zyyyyy07/hpipac-heater/3-mechanical/README.md

[← 上一步:采购](../2-purchase/README.md) · [总览](../README.md) · [下一步:接线 →](../4-electronics/README.md)

# 第 3 步 · 加工金属件、打印外壳

这一步把 8 种定制零件做出来:四件金属件找 CNC 加工厂,四种塑料件 3D 打印(注射筒加热套半壳要做 2 件)。

**下单前先量两个尺寸,在三维查看器里改成实测值再导出**:注射筒外径、加湿罐底面直径。默认值是我估的。

| 图号 | 零件 | 文件 | 做法 | 说明 |
| --- | --- | --- | --- | --- |
| HP-01 | 喷嘴头 | [models/cnc/](models/cnc/)`01_nozzle_tip_316L.step` | 精密车削,316L | 外径 10、高 14 的小件。喷口直径 2.0,与外圆同轴度 0.03 |
| HP-02 | 定心旋流片 | [models/cnc/](models/cnc/)`02_nozzle_spider_316L.step` | 线切割或微铣,316L | 直径约 6、厚 4。中心孔穿毛细管,三条切向槽 |
| HP-03 | 喷头歧管 | [models/cnc/](models/cnc/)`03_nozzle_manifold_AL6061.step` | CNC,6061 铝 | 36×30×50 的块。只接触气体 |
| HP-04 | 注射筒加热套 半壳 | [models/print/](models/print/)`04_syringe_jacket_half.stl` | 3D 打印,**做 2 件** | 两片对扣包住针筒 |
| HP-05 | 加湿铝盘 | [models/cnc/](models/cnc/)`05_humidifier_plate_AL6061.step` | CNC,6061 铝 | 上面放加湿罐,下面贴加热片 |
| HP-06 | 加湿底座 | [models/print/](models/print/)`06_humidifier_base.stl` | 3D 打印,PETG 或耐温 ABS | 托住铝盘,里面走线 |
| HP-07 | 主控盒 | [models/print/](models/print/)`07_control_box_body.stl` | 3D 打印 | 侧面 7 个航空插座孔 |
| HP-08 | 主控盒盖 | [models/print/](models/print/)`08_control_box_lid.stl` | 3D 打印 | 7 英寸触摸屏窗、3 个指示灯、中止键、消音键、蜂鸣器 |

## 发给加工厂

- 图纸是 [drawings/HP-drawings.pdf](drawings/HP-drawings.pdf),每个零件一张 A3,含三视图、孔表、公差和技术要求。二维线稿在 [drawings/dxf/](drawings/dxf/)。
- 金属件发图纸第 1、2、3、5 页,加 `models/cnc/` 里的四个 STEP。
- 打印件发 `models/print/` 里的 STL 或 STEP。
- **喷嘴头和旋流片是毫米级的精密件,普通 CNC 厂不一定做得了。** 找做精密车削、线切割或医疗器械零件的厂。第一轮试水可以先用光固化树脂(SLA)打印这两件,便宜、快,能验证雾化原理,但尺寸精度和表面比金属差。
- 图纸由脚本生成,没有经过加工厂审图,下单前请对方确认能否按图加工。

## 看模型和改尺寸

```
pip install cadquery reportlab ezdxf
cd 3-mechanical/tools
python studio.py        (浏览器打开 http://127.0.0.1:8095)
```

可以旋转、剖切、拖滑块改尺寸。左边列表下方有装配视图:气助雾化喷头(点“剖切”看内部)、注射筒加热套、加湿加热底座、手术室整体布置。点“保存并导出”后模型和图纸按新尺寸重新生成。

喷口直径和毛细管外径决定环形气隙的面积,进而决定气流速度和雾滴大小。这两个参数是第一个要通过试验调的。

## 喷头怎么装

1. 旋流片压进喷嘴头内腔,距喷口端面 5 mm,三条槽朝向一致。
2. 喷嘴头的细段插进喷头杆下端,激光焊或医用环氧胶封固,外表面齐平无台阶。
3. 喷头杆上端插进歧管底孔 20 mm,O 形圈加环氧胶密封。
4. 毛细管从歧管顶部穿入,穿过旋流片中心孔,末端伸出喷口 0.5 mm,顶部用 M6 压紧接头锁住并密封。伸出量可以松开接头微调。
5. 歧管侧面装进气接头和测压接头;背面贴加热片;两只测温探头涂导热硅脂插进测温孔;外面包保温棉。
6. 通气检查:堵住喷口,歧管充气到 100 kPa,泡水里看有无气泡。

毛细管要在喷口正中。装好后对着光从喷口正面看,环形缝隙应当一圈均匀。偏了雾会歪向一边。

## 其他装配要点

- **注射筒加热套**:硅胶加热片贴在一片半壳内侧,外面垫保温棉;两只测温探头贴在加热片和针筒之间。不要挡住注射泵的推杆和针筒刻度。
- **加湿加热底座**:加热片贴在铝盘底面,铝盘用 3 颗 M3 沉头螺丝固定在底座上,中间垫硅胶隔热垫。铝盘最高到 85 ℃,底座外壁会热。
- **喷头的固定**:喷头连歧管约 150 g,加上输气管的拉力,不能只靠穿刺器撑着。输气管和药液细管要用支架或绑带托住,不让重量和拉力落在喷头上。
- **主控盒**:模块的固定位置按实物在盒底打孔或贴双面胶。

以上装配方式都没有做过实物验证。

---

[← 上一步:采购](../2-purchase/README.md) · [总览](../README.md) · [下一步:接线 →](../4-electronics/README.md)
