zyyyyy07/hpipac-heater/1-design/interface-spec.md

[← 设计方案](README.md) · [总览](../README.md)

# 接口约定(固件、服务器、页面共用)

这份文件是固件、盒内服务程序和触摸屏界面之间的约定。改了一处,另外两处要同时改。

## 1. 系统组成

hPIPAC 前端加热系统由一台主机、四路加热和一只气助加热雾化喷头组成。循环泵送出的温热加湿 CO₂ 从喷头喷出,同时当作雾化气把药液打成雾。主机不控制推药的注射泵和气腹机,这两台是独立的成品设备。

| 代号 | 名称 | 加热什么 | 控制目标 | 硬上限 |
| --- | --- | --- | --- | --- |
| SYR | 注射筒加热套 | 注射泵针筒里的药液 | 套温 = 目标温度 | 套温 43.0 ℃ |
| NOZ | 喷头歧管加热 | 喷头体外部分的歧管(气和药液在这里汇合进喷头杆) | 歧管温度 = 目标温度 | 歧管 43.0 ℃ |
| HUM | 加湿加热底座 | 加湿罐里的水,使 CO₂ 加热加湿 | 罐出口气温 = 目标温度 + 1 ℃ | 底座 85 ℃,出口气温 45 ℃ |
| TUBE | 加热输气管 | 加湿罐到喷头歧管的输气管 | 喷头端气温 = 目标温度 | 喷头端气温 43.5 ℃ |

另有一台循环泵 PUMP,把腹腔里的 CO₂ 经过滤器抽出、加热加湿后从喷头送回,流量 0–15 L/min。喷雾时这股气流就是雾化气,所以喷雾阶段泵必须转。

目标温度 `target`:37.0–43.0 ℃,默认 42.0 ℃。药液通路上任何加热面的设定值都不超过 43.0 ℃。

## 2. 传感器

| 字段 | 含义 | 单位 |
| --- | --- | --- |
| `syr1`, `syr2` | 注射筒加热套温度(控制、保护各一只) | ℃ |
| `noz1`, `noz2` | 喷头歧管温度(控制、保护各一只) | ℃ |
| `humPlate` | 加湿底座温度 | ℃ |
| `humOut` | 加湿罐出口气温 | ℃ |
| `gasEnd` | 输气管喷头端气温 | ℃ |
| `ip1`, `ip2` | 腹腔内温度探头 1、2 | ℃ |
| `press` | 腹腔压力(循环回路上测) | mmHg |
| `nozP` | 喷头歧管处的雾化气压(表压) | kPa |
| `flow` | 循环流量 | L/min |

传感器开路或短路时固件上报 `null`。

## 3. 阶段

```
IDLE → PREHEAT → READY → NEBULIZE → EXPOSE → EVAC → DONE → IDLE
```

| 阶段 | 含义 | 加热 | 循环泵 |
| --- | --- | --- | --- |
| IDLE | 待机 | 全关 | 关 |
| PREHEAT | 预热:药液、喷头歧管、加湿器升温;气腹建立后循环 CO₂ 给腹腔升温 | 四路全开 | `press` ≥ 8 mmHg(气腹已建立)后按设定流量,之前不转 |
| READY | 就绪:四路都到温,腹腔温度到目标 − 1 ℃ 以内(或操作者手动确认) | 保持 | 按设定流量 |
| NEBULIZE | 喷雾:操作者启动注射泵推药 | 四路保持 | 按 `nebFlow` 运转(这是雾化气,泵停了就不成雾) |
| EXPOSE | 暴露计时(默认 30 分钟) | SYR 关;NOZ 关;HUM、TUBE 保持 | 由 `circInExpose` 决定,默认关 |
| EVAC | 排气:提示操作者经密闭排气系统排空气腹 | 全关 | 关 |
| DONE | 结束,等待确认 | 全关 | 关 |

转换:
- `preheat` 命令:IDLE → PREHEAT。
- PREHEAT → READY:自动。条件是 SYR、NOZ 的两只传感器都在目标 ±0.5 ℃ 内,`gasEnd` ≥ 目标 − 1 ℃,并且 `ip1`、`ip2` 的平均值 ≥ 目标 − 1 ℃。腹腔条件可用 `ready` 命令手动跳过。
- READY 掉回 PREHEAT:任一条件失去超过 60 秒。
- `nebulize` 命令:READY → NEBULIZE。只允许从 READY 进入。
- `expose` 命令:NEBULIZE → EXPOSE,开始计时。
- EXPOSE → EVAC:计时到 `exposeMin` 自动转,或 `evac` 命令提前转。
- `finish` 命令要发两次:第一次 EVAC → DONE,第二次 DONE → IDLE。
- **喷雾阶段泵一停就不成雾了,而注射泵不归本机控制,还在推药。** 这时任何让泵停下的报警(压力高、压力低、喷头堵塞、传感器故障、腹腔过温、气体过温)都要求操作者立即停注射泵。触摸屏在这种情况下必须用最醒目的方式提示“立即停止注射泵”,红灯快闪,蜂鸣器急响。
- 循环泵不转的时候(气腹未建立、暴露默认、报警停泵后),HUM 的底座温度上限从 85 ℃ 降到 60 ℃ 待机,避免没有气流时把底座烧到很高。
- `abort` 命令:任何阶段 → EVAC(加热和泵立即全关)。

## 4. 报警

高级报警立即把相关加热和循环泵关掉。带“锁定”的只有重新上电才能清除。

| 名称 | 条件 | 级别 | 动作 |
| --- | --- | --- | --- |
| `OVERTEMP_DRUG` | `syr1/2` 或 `noz1/2` ≥ 43.8 ℃ | 高,锁定 | SYR、NOZ 关 |
| `OVERTEMP_GAS` | `gasEnd` ≥ 44.5 ℃,或 `humOut` ≥ 46 ℃,或 `humPlate` ≥ 88 ℃ | 高,锁定 | HUM、TUBE、PUMP 关 |
| `IP_HIGH` | `ip1` 或 `ip2` ≥ 43.5 ℃ | 高 | 四路全关,PUMP 关;降到 42.5 ℃ 以下并经 `ack` 才恢复 |
| `SENSOR` | 成对传感器相差 > 1.5 ℃ 持续 10 秒,或任一控制用传感器为 `null` | 高,锁定 | 对应通路关 |
| `PRESS_HIGH` | `press` ≥ 18 mmHg 持续 3 秒 | 高 | PUMP 关 |
| `PRESS_LOW` | 循环泵运转中 `press` ≤ 6 mmHg 持续 5 秒。泵没转时不判 | 高 | PUMP 关(可能漏气),`ack` 后恢复 |
| `WATER_LOW` | 循环泵已连续运转 ≥ 120 秒,`humPlate` ≥ 75 ℃ 而 `humOut` 低于目标 3 ℃ 以上,持续 120 秒。泵没转时不判 | 中 | HUM 关,`ack` 后恢复 |
| `NOZ_BLOCK` | `nozP` ≥ 150 kPa 持续 3 秒(喷嘴堵了或输气管打折) | 高 | PUMP 关,`ack` 后恢复 |
| `NOZ_LOW` | NEBULIZE 中循环泵已运转 ≥ 10 秒,`nozP` < 30 kPa 持续 10 秒(气压不够,雾滴会变粗;可能漏气或流量太低) | 中 | 仅提示 |
| `PREHEAT_SLOW` | PREHEAT 超过 60 分钟 | 中 | 仅提示 |
| `IP_LOW` | EXPOSE 中 `ip` 平均值低于目标 2 ℃ 以上,持续 5 分钟 | 中 | 仅提示 |
| `EXPOSE_END` | 暴露计时到 | 中 | 仅提示 |

## 5. 遥测(固件 → 服务器)

固件每 2 秒 `POST /api/device/telemetry`,JSON:

```json
{"id":"HP-001","ph":"PREHEAT","target":42.0,"exposeMin":30,"flowSet":10.0,"nebFlow":12.0,"circInExpose":false,
 "t":{"syr1":41.8,"syr2":41.7,"noz1":42.0,"noz2":41.9,"humPlate":61.2,"humOut":43.0,"gasEnd":41.6,"ip1":40.2,"ip2":39.8},
 "press":12.1,"nozP":62.0,"flow":9.8,
 "duty":{"syr":35,"noz":20,"hum":60,"tube":40,"pump":65},
 "phSec":412,"exposeLeft":-1,"al":["IP_LOW"],"muted":false}
```

- `ph`:阶段名。`phSec`:进入当前阶段的秒数。`exposeLeft`:暴露剩余秒数,不在 EXPOSE 时为 −1。
- `duty`:各路输出占空比,0–100。
- 服务器的响应体:`{"cmds":[...]}`,每条命令形如 `{"kind":"preheat"}` 或 `{"kind":"target","value":41.5}`。

## 6. 命令

| `kind` | `value` | 说明 |
| --- | --- | --- |
| `preheat` | — | 开始预热 |
| `ready` | — | 手动确认就绪(跳过腹腔温度条件) |
| `nebulize` | — | 标记喷雾开始 |
| `expose` | — | 标记喷雾结束,开始暴露计时 |
| `evac` | — | 提前结束暴露 |
| `finish` | — | 结束本次手术 |
| `abort` | — | 中止:加热和泵全关,进入 EVAC |
| `target` | 37.0–43.0 | 改目标温度 |
| `flow` | 0–15 | 改循环流量 L/min(预热、就绪、暴露阶段用) |
| `nebFlow` | 5–15 | 改喷雾阶段的雾化气流量 L/min,默认 12 |
| `exposeMin` | 1–60 | 改暴露时间 |
| `circInExpose` | true/false | 暴露阶段是否循环 |
| `ack` | — | 确认可恢复的报警 |
| `mute` | — | 消音 2 分钟 |

固件拒绝超范围的值和当前阶段不允许的命令。

## 7. 盒内服务程序接口

主机是一个整体,只在现场操作,**没有遥控**。主控盒里的树莓派运行服务程序,开一个只供盒内使用的 Wi-Fi 热点,ESP32 连这个热点,不接医院网络。触摸屏全屏显示服务程序提供的本机界面。

| 方法 | 路径 | 说明 |
| --- | --- | --- |
| POST | `/api/device/telemetry` | ESP32 上报,返回待执行命令 |
| GET | `/api/state` | 返回 `{now, devices:[{id, online, last, case}]}` |
| POST | `/api/cmd` | `{dev, kind, value}`,触摸屏上的操作排入命令队列 |
| GET | `/api/history?dev=&sec=` | 最近若干秒的遥测点,供触摸屏画曲线 |
| GET | `/api/case/log?dev=&case=` | 一次手术的全部记录(CSV) |
| GET | `/`、`/local` | 触摸屏本机界面(800×480) |
| GET | `/panel` | 主机面板模拟页面,开发和演示用 |

记录:每次从 PREHEAT 开始到回到 IDLE,服务程序自动把每条遥测写进一个 CSV 文件,存在树莓派的存储卡上,手术结束后可以拷出来。

设备 5 秒没有上报视为离线,触摸屏显示“主控无响应”。
