zyyyyy07/hpipac-heater/2-purchase/README.md

[← 上一步:方案设计](../1-design/README.md) · [总览](../README.md) · [下一步:结构件 →](../3-mechanical/README.md)

# 第 2 步 · 采购

照下面的清单买齐零件。定制的金属件和打印件不在这里买,在[第 3 步](../3-mechanical/README.md)下单加工。价格是粗略估计,仅用于预算。

## 喷头用的外购件

| # | 零件 | 规格 | 数量 | 约价 元 |
| --- | --- | --- | --- | --- |
| 1 | 喷头杆 | 316L 不锈钢管,外径 10 mm、壁厚 1 mm,切 200 mm,两端去毛刺 | 2 | 30 |
| 2 | 药液毛细管 | 316L 不锈钢毛细管,外径 1.6 mm、内径 1.0 mm,长 300 mm,端面平整无毛刺 | 5 | 30 |
| 3 | 毛细管接头 | M6 压紧接头(卡套或 PEEK 压环,适配 1.6 mm 管);1.6 mm 管转鲁尔接头 | 各 2 | 60 |
| 4 | 进气接头 | G1/8 宝塔或快插接头,适配输气管;M5 测压接头 | 各 2 | 20 |
| 5 | 密封 | O 形圈(内径 10 mm);医用环氧胶 | 1 套 | 30 |
| 6 | 药液细管 | 鲁尔接口延长管,内径约 1 mm,长 1.5 m | 若干 | 5/根 |

## 主机和控制

| # | 零件 | 规格 | 数量 | 约价 元 |
| --- | --- | --- | --- | --- |
| 7 | 主控板 | ESP32-DevKitC(ESP32-WROOM-32,38 脚) | 1 | 25 |
| 8 | 模数转换 | ADS1115 16 位 I2C 模块 | 3 | 45 |
| 9 | 功率开关 | MOS 管驱动模块(3.3 V 逻辑可驱动,≥10 A) | 6 | 40 |
| 10 | 触摸屏 | 树莓派官方 7 英寸触摸屏(800×480) | 1 | 450 |
| 11 | 屏幕主机 | 树莓派 4B 或 3B+,16 GB 以上 TF 卡 | 1 | 350 |
| 12 | 声光 | 有源蜂鸣器模块;5 mm LED 红黄绿;330 Ω 电阻 | 1 套 | 8 |
| 13 | 按键 | 16 mm(中止)和 12 mm(消音)面板自复位按键 | 各 1 | 10 |
| 14 | 电源 | 24 V 10 A 开关电源(样机用普通电源,成品必须换医用电源);24 V 转 5 V 3 A 降压模块 2 个;15 A 保险丝座 | 1 套 | 150 |
| 15 | 连接器与线 | GX16 航空插头座 5 对,GX12 2 对,硅胶线 | 1 套 | 80 |

## 测温和测压

| # | 零件 | 规格 | 数量 | 约价 元 |
| --- | --- | --- | --- | --- |
| 16 | 温度探头 | 10 kΩ B3950 1% NTC,Ø2 mm 探头带线(注射筒套 2、歧管 2、加湿底座 1) | 6 | 20 |
| 17 | 气温探头 | 同上,细探头,插进输气管两端的测温口 | 2 | 8 |
| 18 | 腹腔温度探头 | 医用体腔温度探头(热敏电阻,线长 ≥2 m)。台架阶段可用防水 NTC 代替 | 2 | 100–400 |
| 19 | 精密电阻 | 10 kΩ 0.1%(腹腔探头阻值不同时按探头配);10 kΩ、20 kΩ 1% 分压用 | 1 套 | 10 |
| 20 | 腹腔压力传感器 | 0–50 mmHg(约 0–7 kPa)表压,0.5–4.5 V 输出 | 1 | 80–200 |
| 21 | 雾化气压传感器 | 0–200 kPa 表压,0.5–4.5 V 输出,M5 或鲁尔接口 | 1 | 50–150 |

## 加热

| # | 零件 | 规格 | 数量 | 约价 元 |
| --- | --- | --- | --- | --- |
| 22 | 注射筒加热片 | 硅胶加热片 24 V 20 W,约 80×90 mm,带背胶 | 1 | 30 |
| 23 | 歧管加热片 | 聚酰亚胺薄膜加热片 24 V 10 W,约 30×45 mm | 1 | 15 |
| 24 | 加湿底座加热片 | 圆形硅胶加热片 24 V 120 W,直径约 90 mm | 1 | 60 |
| 25 | 独立过温保护 | XH-W1209 数显温控模块(24 V 版或配降压) | 3 | 30 |
| 26 | 机械过温保护 | KSD9700 常闭温控开关:50 ℃ 2 只(药液侧),95 ℃ 1 只(加湿底座);温度保险丝 72 ℃ 2 只、115 ℃ 1 只 | 1 套 | 15 |
| 27 | 保温 | 3 mm 气凝胶毡或闭孔泡棉;3 mm 硅胶隔热垫 | 1 | 30 |

## 气路

进腹腔的气体经过的部分都用无菌一次性耗材。

| # | 零件 | 规格 | 数量 | 约价 元 |
| --- | --- | --- | --- | --- |
| 28 | 加湿罐 | 一次性呼吸湿化罐(自动加水式),底面是铝盘,无菌。要能承受约 100 kPa 的内压,买之前向厂家确认 | 若干 | 30–80/个 |
| 29 | 加热输气管 | 带加热丝的一次性输气管,长 1.5–2 m,耐压 ≥100 kPa | 若干 | 50–200/根 |
| 30 | 气溶胶过滤器 | 腹腔镜排烟用或呼吸回路用高效疏水过滤器(过滤效率 ≥99.99%),2 级串联 | 若干 | 20–60/个 |
| 31 | 循环泵 | 24 V 无油隔膜气泵或小型无油压缩机:12–15 L/min 时出口压力 ≥100 kPa,可调速,气路与电机隔离 | 1 | 300–800 |
| 32 | 管路和接头 | 耐压医用硅胶管或 PU 管、鲁尔接头、三通 | 1 套 | 80 |
| 33 | 灭菌注射用水 | 加湿罐用 | — | — |

普通呼吸湿化罐和输气管是按很低的压力设计的。本方案里它们在泵的出口侧,要承受几十 kPa。**买不到耐压的,就要把加湿罐放进一个耐压外罩里,或者改成泵在加湿罐之后。** 这一点我没有解决,见[第 7 步](../7-testing/README.md)的风险点。

## 安装和加工

| # | 零件 | 规格 | 数量 | 约价 元 |
| --- | --- | --- | --- | --- |
| 34 | 设备架 | 带托板的移动立杆或小推车;抱杆夹 | 1 | 200 |
| 35 | 固定 | 魔术贴绑带;M3、M4 螺丝 | 1 套 | 30 |
| 36 | 金属件加工 | 喷嘴头、定心旋流片(316L,精密小件),歧管、加湿铝盘(6061),见[第 3 步](../3-mechanical/README.md) | 1 套 | 800–2000 |
| 37 | 3D 打印 | 5 件,PETG | 1 套 | 150–300 |

## 由医院提供、不在本清单里的

注射泵和针筒、气腹机、穿刺器、密闭排气系统。本系统不改动它们。

**下单前先量两个尺寸**:注射筒外径、加湿罐底面直径。

台架测试还需要:经计量的温度计、细热电偶和记录仪、模型腹腔(密闭塑料箱加硅胶膜)、水柱压力计、电子天平(0.01 g)、食用色素或荧光素、生理盐水。测雾滴粒径需要激光粒度仪,通常要找有设备的实验室。

---

[← 上一步:方案设计](../1-design/README.md) · [总览](../README.md) · [下一步:结构件 →](../3-mechanical/README.md)
