zyyyyy07/hpipac-heater/3-mechanical/models/view/syr_assembly.stl

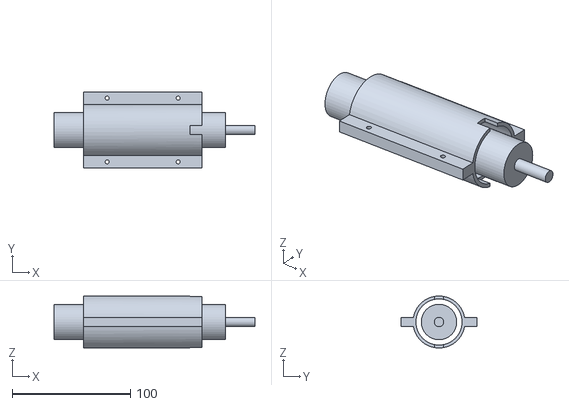
[picture p1: CAD file, 2026-11-13]
3-mechanical/models/view/syr_assembly.stl
170.0 x 64.0 x 43.9
