zyyyyy07/hpipac-heater/3-mechanical/models/view/hum_assembly.stl

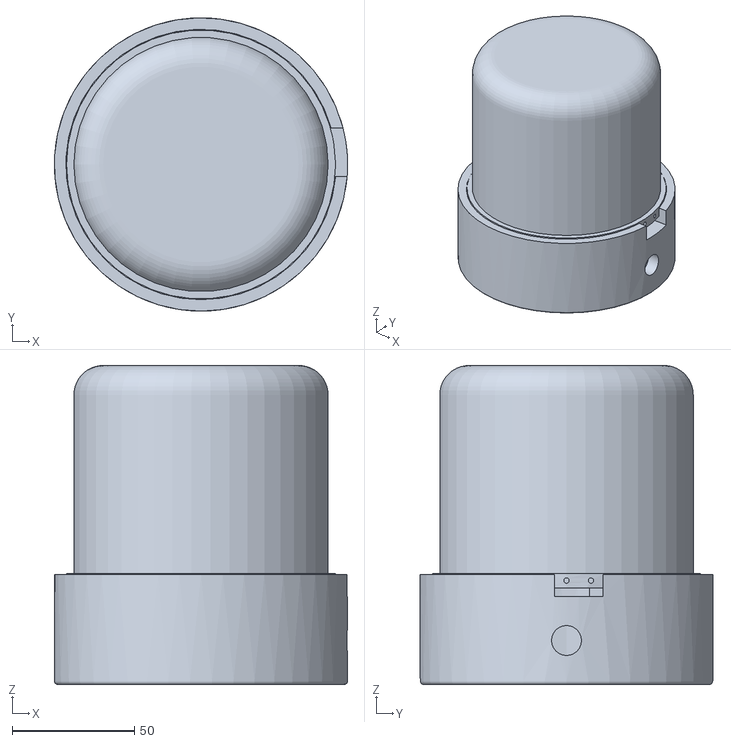
[picture p2: CAD file, 2026-11-13]
3-mechanical/models/view/hum_assembly.stl
120.0 x 120.0 x 130.5
