zyyyyy07/hpipac-heater/3-mechanical/models/view/room_assembly.stl

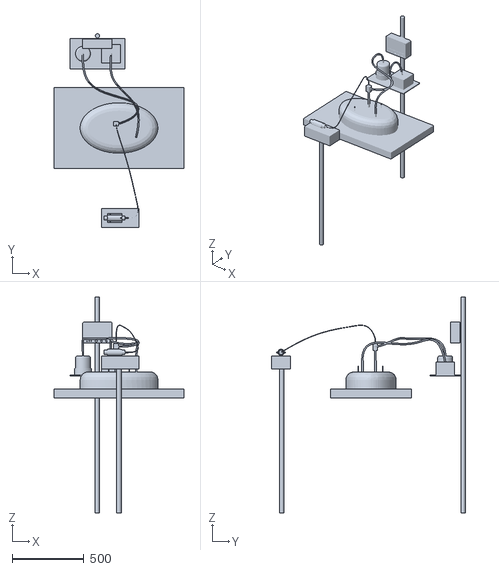
[picture p3: CAD file, 2026-11-13]
3-mechanical/models/view/room_assembly.stl
900.0 x 1345.0 x 1500.0
