zyyyyy07/hpipac-heater/3-mechanical/models/view/nozzle_assembly.stl

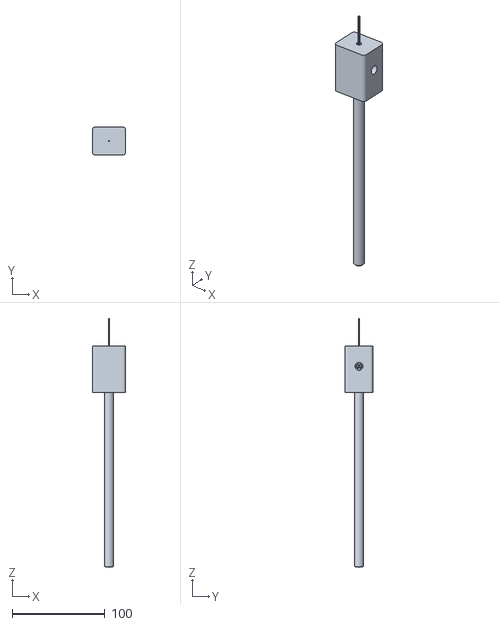
[picture p4: CAD file, 2026-11-13]
3-mechanical/models/view/nozzle_assembly.stl
36.0 x 30.0 x 268.0
