zyyyyy07/hpipac-heater/3-mechanical/drawings/dxf/01_nozzle_tip_316L.dxf

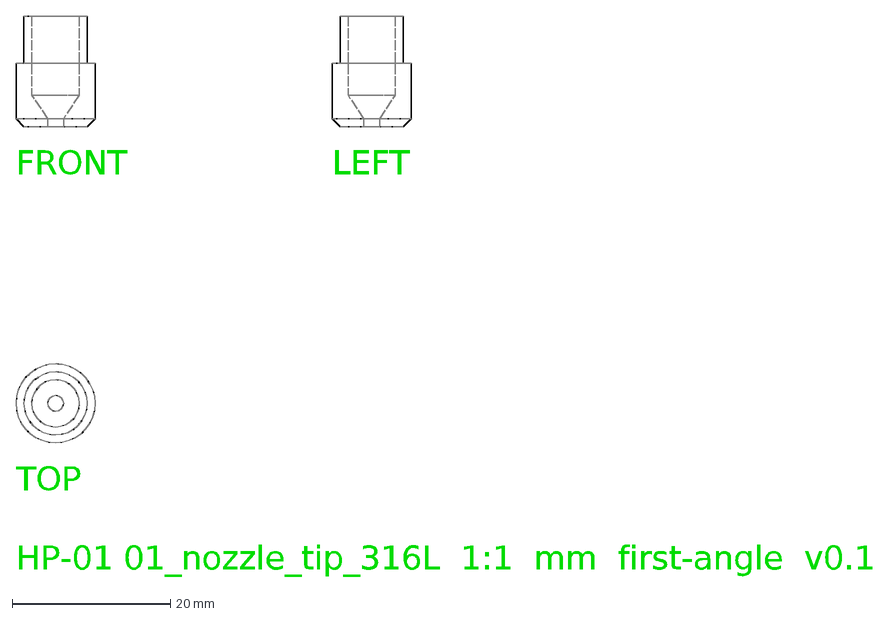
[picture p5: CAD file, 2026-11-13]
3-mechanical/drawings/dxf/01_nozzle_tip_316L.dxf
FRONT
TOP
LEFT
HP-01 01_nozzle_tip_316L 1:1 mm first-angle v0.1
