zyyyyy07/hpipac-heater/3-mechanical/models/cnc/01_nozzle_tip_316L.step

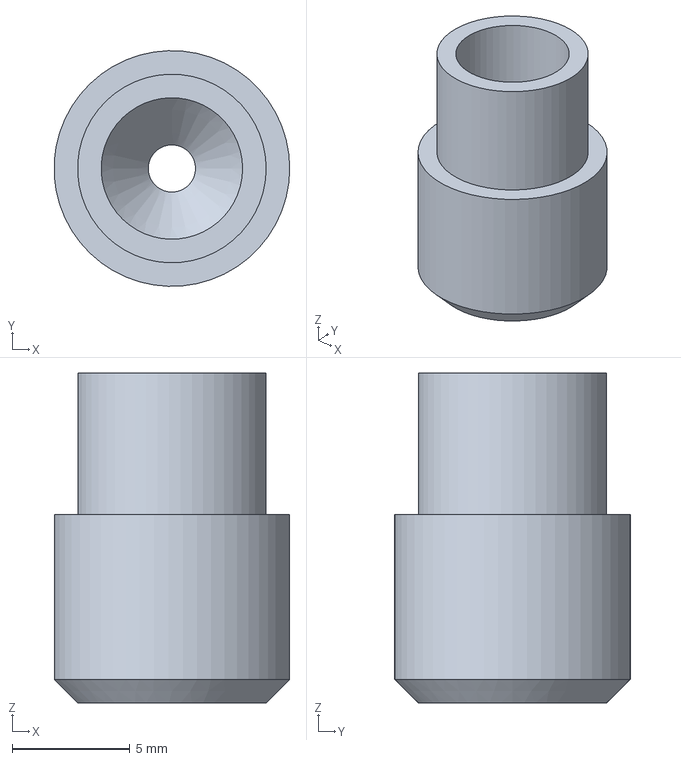
[picture p6: CAD file, 2026-11-13]
3-mechanical/models/cnc/01_nozzle_tip_316L.step
9.99 x 10.00 x 14.0 mm
