zyyyyy07/hpipac-heater/3-mechanical/models/print/04_syringe_jacket_half.step

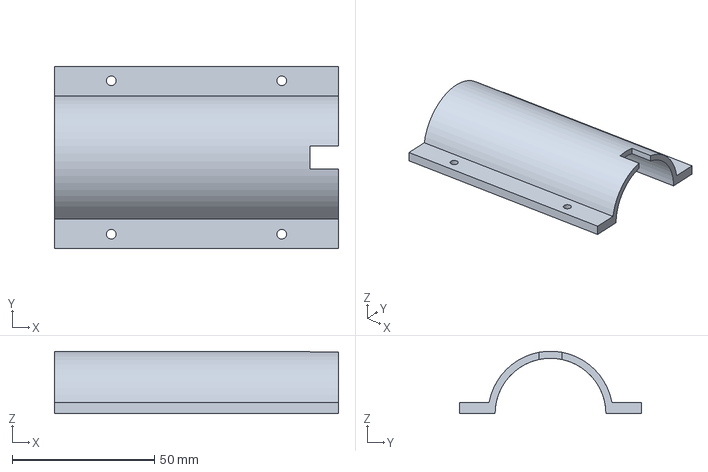
[picture p7: CAD file, 2026-11-13]
3-mechanical/models/print/04_syringe_jacket_half.step
100.0 x 64.0 x 22.0 mm
