zyyyyy07/hpipac-heater/3-mechanical/models/cnc/05_humidifier_plate_AL6061.step

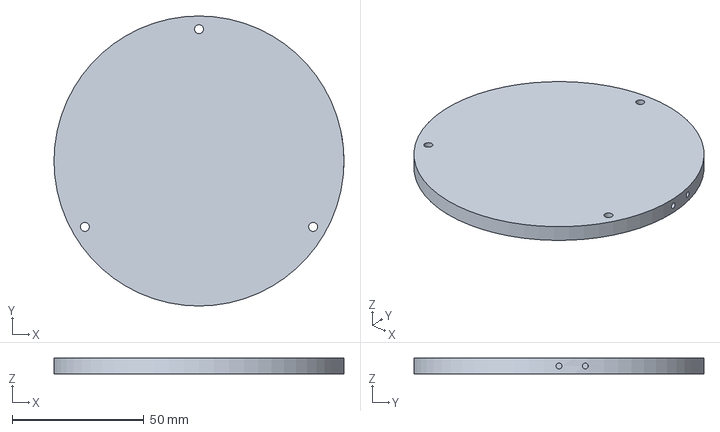
[picture p9: CAD file, 2026-11-13]
3-mechanical/models/cnc/05_humidifier_plate_AL6061.step
110.0 x 110.0 x 6.00 mm
