zyyyyy07/hpipac-heater/3-mechanical/models/print/06_humidifier_base.step

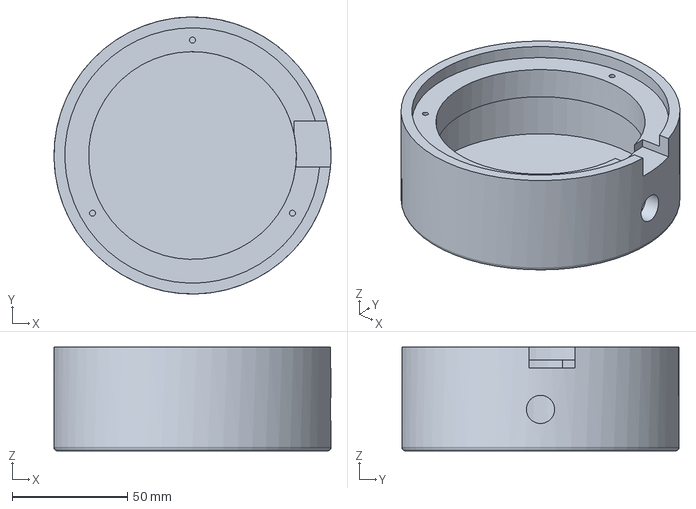
[picture p10: CAD file, 2026-11-13]
3-mechanical/models/print/06_humidifier_base.step
120.0 x 120.0 x 45.0 mm
