zyyyyy07/hpipac-heater/3-mechanical/drawings/dxf/07_control_box_body.dxf

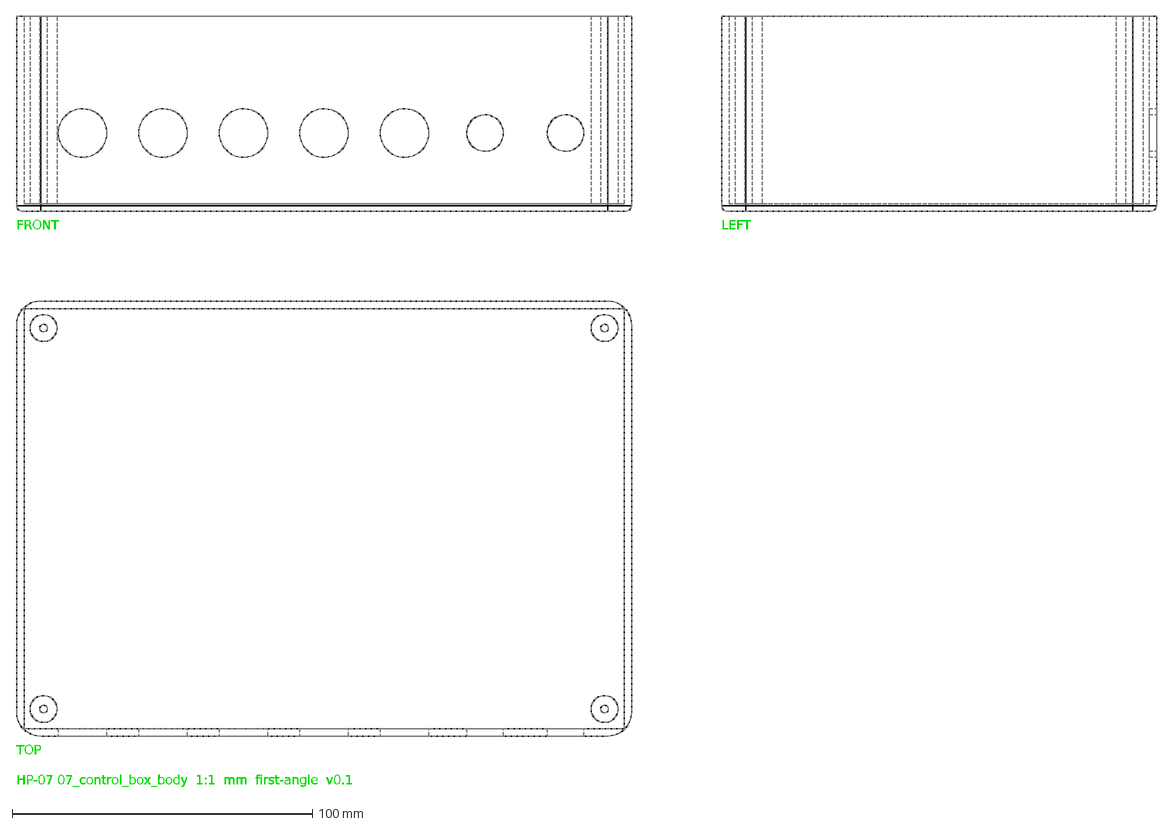
[picture p11: CAD file, 2026-11-13]
3-mechanical/drawings/dxf/07_control_box_body.dxf
FRONT
TOP
LEFT
HP-07 07_control_box_body 1:1 mm first-angle v0.1
