zyyyyy07/hpipac-heater/3-mechanical/models/cnc/03_nozzle_manifold_AL6061.step

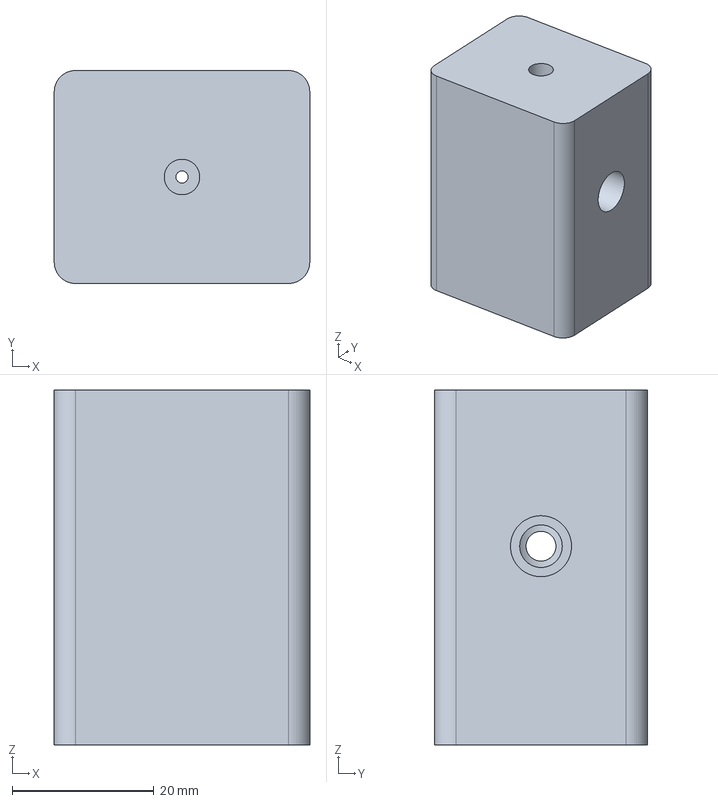
[picture p12: CAD file, 2026-11-13]
3-mechanical/models/cnc/03_nozzle_manifold_AL6061.step
36.0 x 30.0 x 50.0 mm
