zyyyyy07/hpipac-heater/3-mechanical/models/print/08_control_box_lid.step

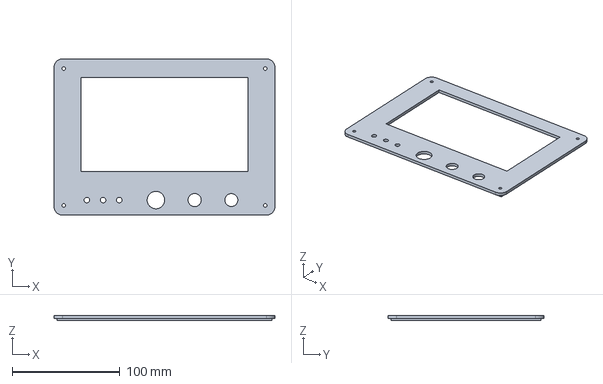
[picture p13: CAD file, 2026-11-13]
3-mechanical/models/print/08_control_box_lid.step
205.0 x 145.0 x 5.00 mm
