zyyyyy07/hpipac-heater/3-mechanical/models/cnc/02_nozzle_spider_316L.step

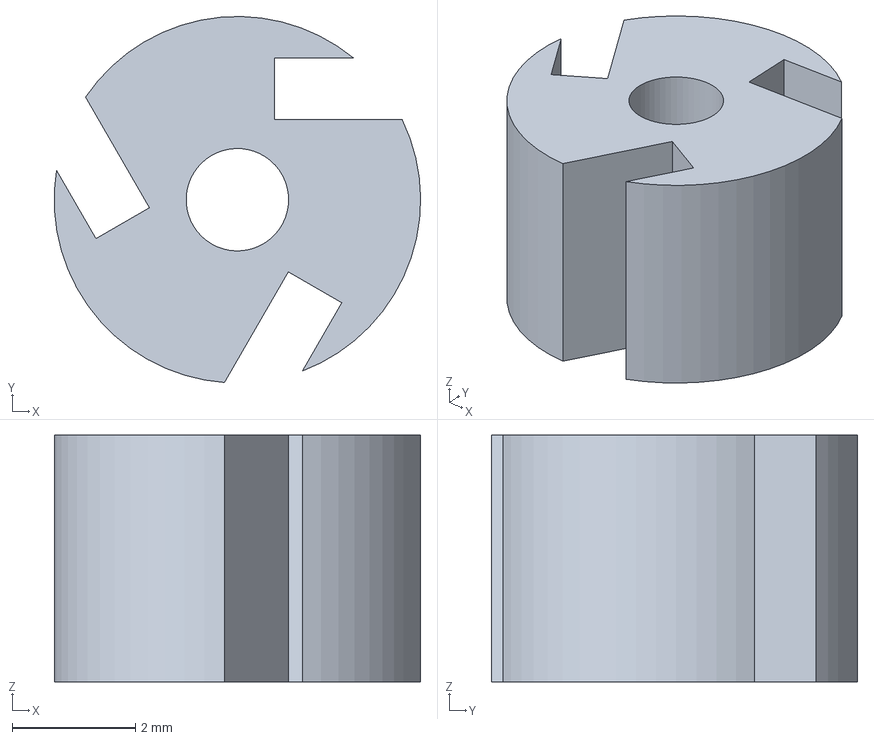
[picture p15: CAD file, 2026-11-13]
3-mechanical/models/cnc/02_nozzle_spider_316L.step
5.94 x 5.93 x 4.00 mm
