zyyyyy07/hpipac-heater/3-mechanical/models/print/07_control_box_body.step

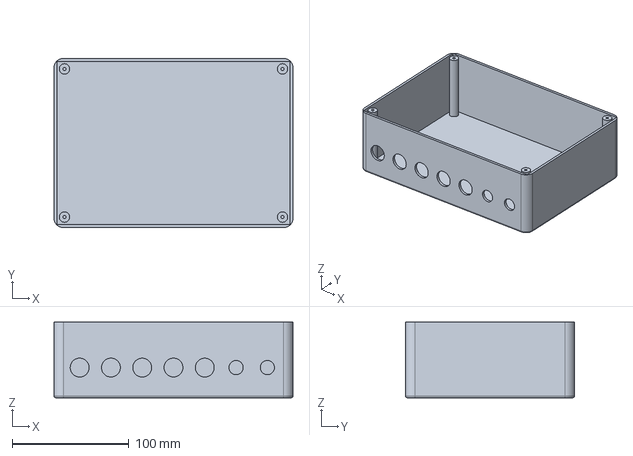
[picture p16: CAD file, 2026-11-13]
3-mechanical/models/print/07_control_box_body.step
205.0 x 145.0 x 65.0 mm
