zyyyyy07/hpipac-heater/3-mechanical/drawings/dxf/03_nozzle_manifold_AL6061.dxf

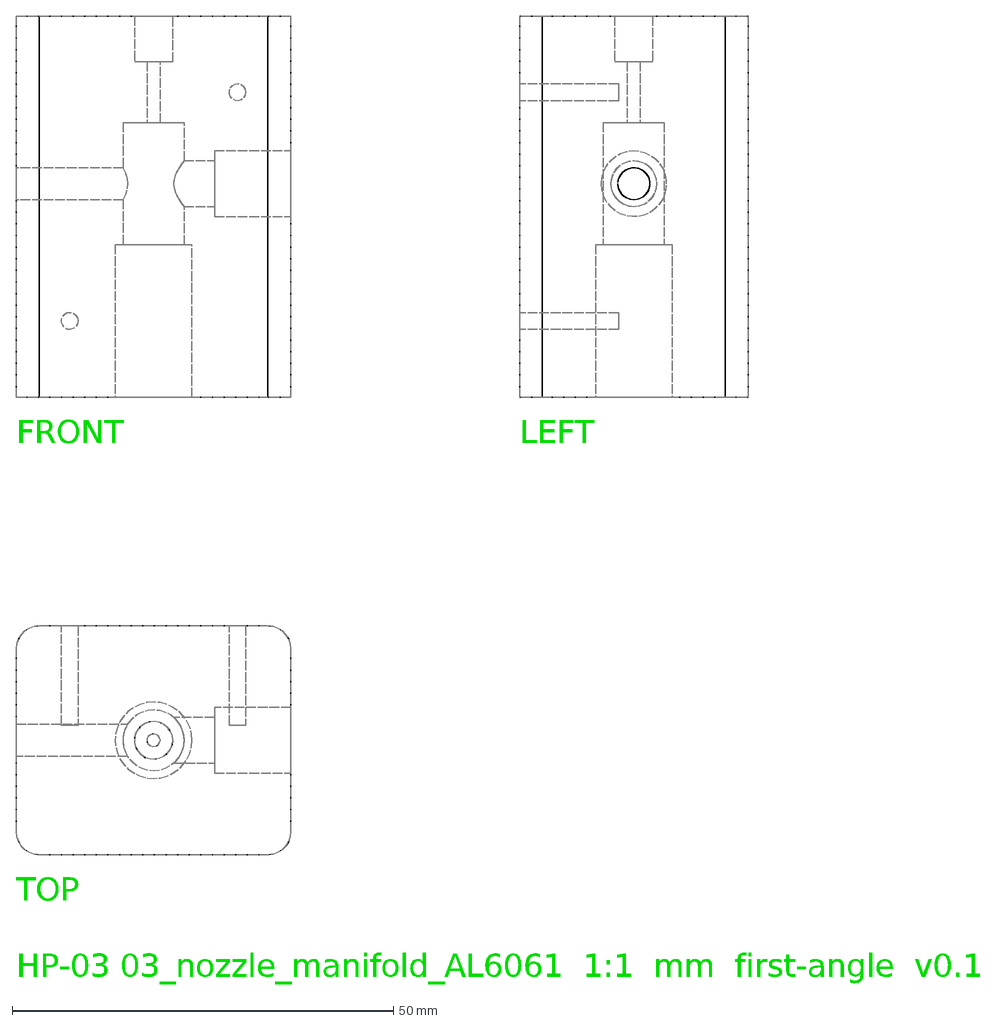
[picture p18: CAD file, 2026-11-13]
3-mechanical/drawings/dxf/03_nozzle_manifold_AL6061.dxf
FRONT
TOP
LEFT
HP-03 03_nozzle_manifold_AL6061 1:1 mm first-angle v0.1
