zyyyyy07/hpipac-heater/3-mechanical/models/cnc/02_plate_upper_AL6061.step

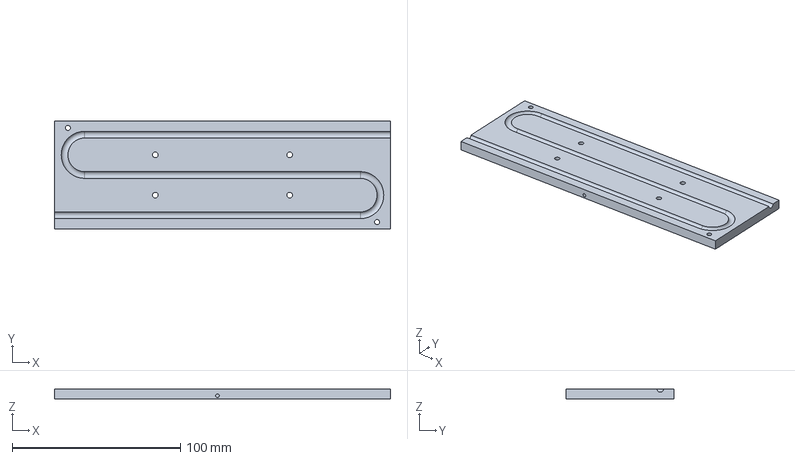
[picture p21: CAD file, 2026-11-12]
3-mechanical/models/cnc/02_plate_upper_AL6061.step
200.0 x 64.0 x 6.00 mm
