zyyyyy07/hpipac-heater/3-mechanical/models/print/05_syringe_jacket_half.step

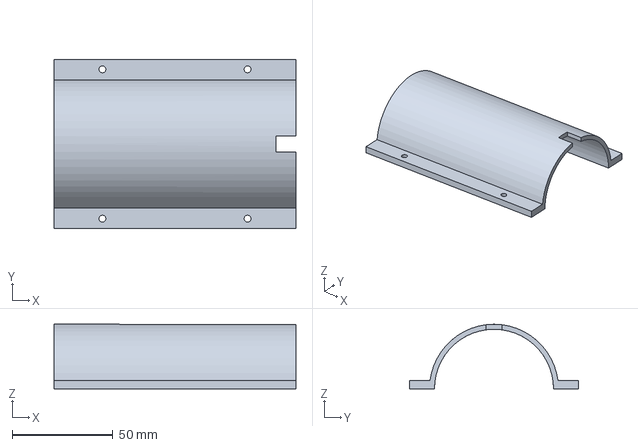
[picture p22: CAD file, 2026-11-13]
3-mechanical/models/print/05_syringe_jacket_half.step
120.0 x 84.0 x 32.0 mm
