zyyyyy07/hpipac-heater/3-mechanical/drawings/dxf/02_nozzle_spider_316L.dxf

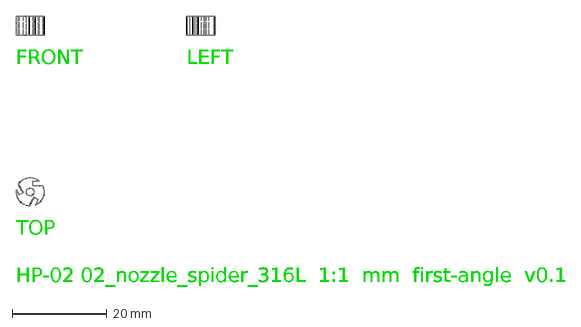
[picture p23: CAD file, 2026-11-13]
3-mechanical/drawings/dxf/02_nozzle_spider_316L.dxf
FRONT
TOP
LEFT
HP-02 02_nozzle_spider_316L 1:1 mm first-angle v0.1
