zyyyyy07/hpipac-heater/3-mechanical/drawings/dxf/07_humidifier_base.dxf

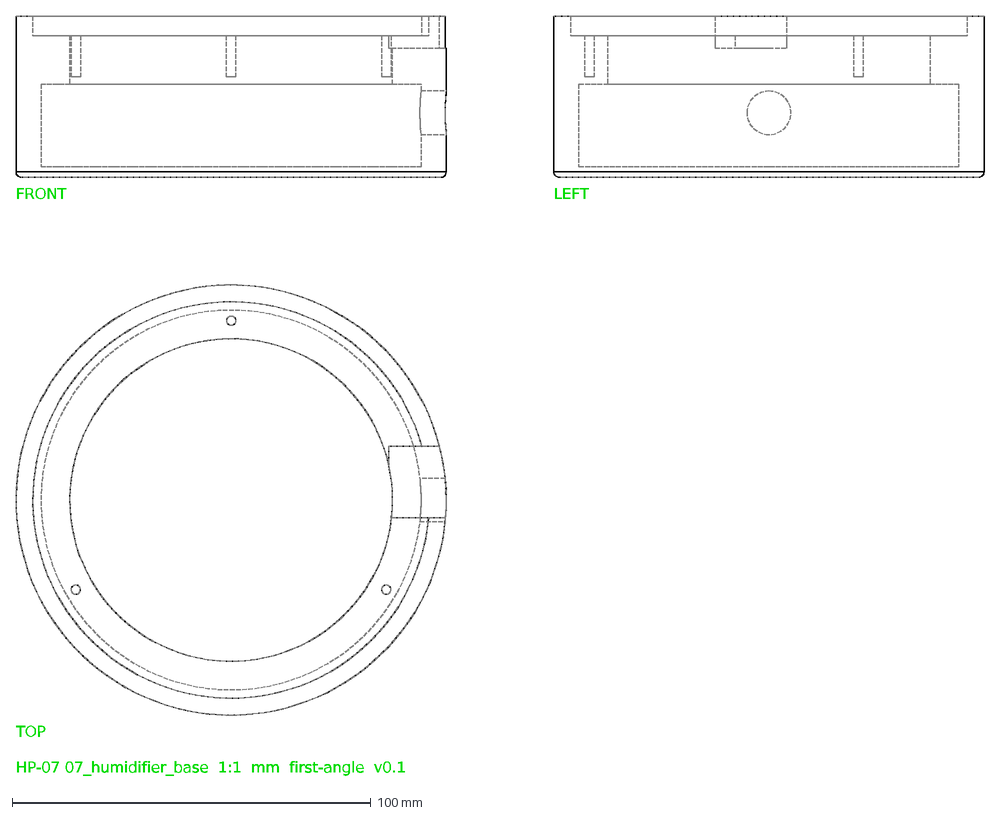
[picture p24: CAD file, 2026-11-13]
3-mechanical/drawings/dxf/07_humidifier_base.dxf
FRONT
TOP
LEFT
HP-07 07_humidifier_base 1:1 mm first-angle v0.1
