zyyyyy07/hpipac-heater/3-mechanical/models/print/03_heater_shell_lower.step

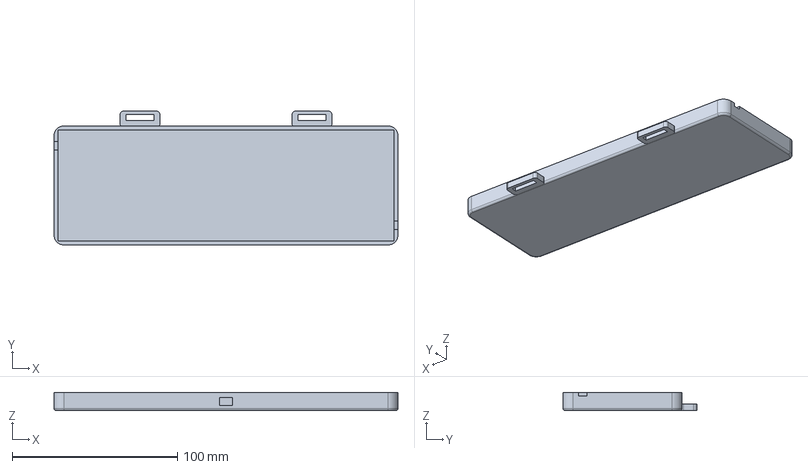
[picture p25: CAD file, 2026-11-12]
3-mechanical/models/print/03_heater_shell_lower.step
208.0 x 81.0 x 11.0 mm
