zyyyyy07/hpipac-heater/3-mechanical/models/print/04_heater_shell_upper.step

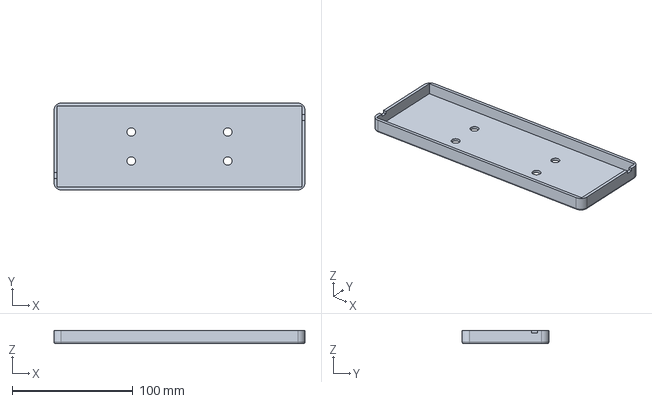
[picture p27: CAD file, 2026-11-12]
3-mechanical/models/print/04_heater_shell_upper.step
208.0 x 72.0 x 11.0 mm
