zyyyyy07/hpipac-heater/3-mechanical/drawings/dxf/09_control_box_lid.dxf

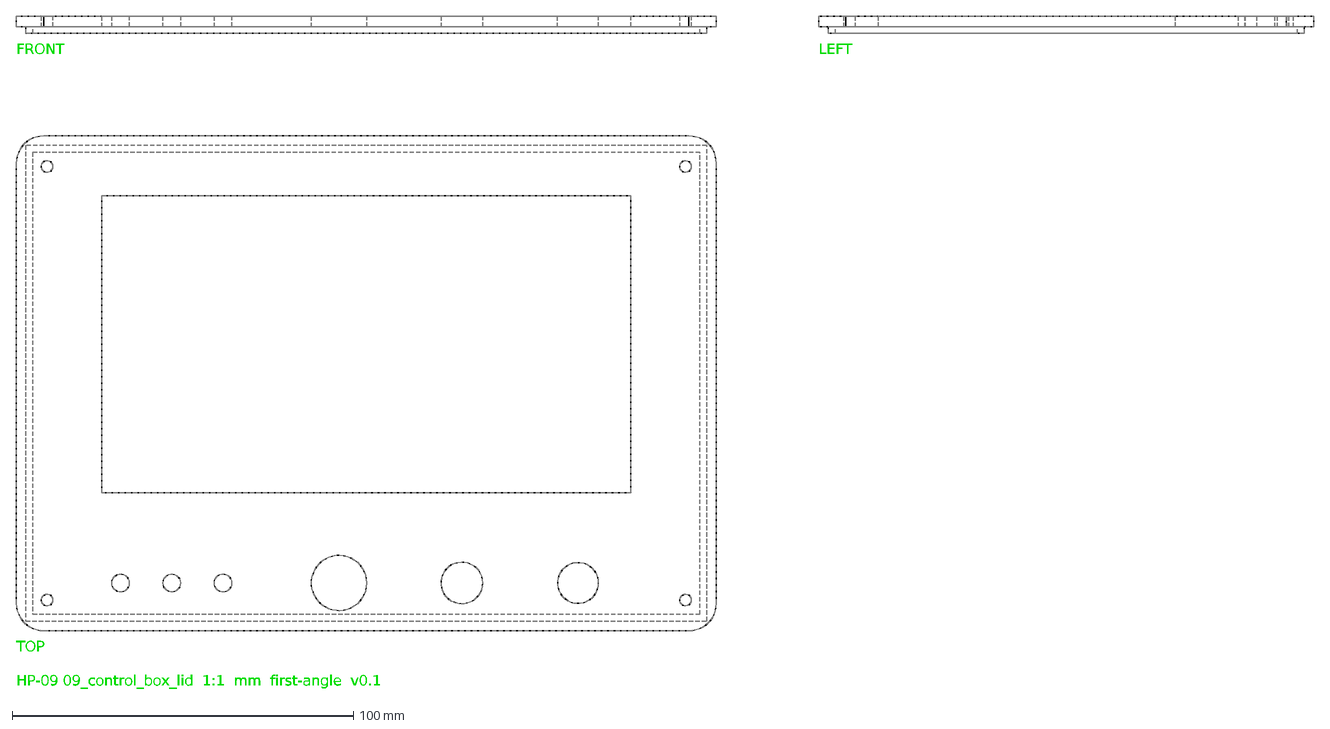
[picture p28: CAD file, 2026-11-13]
3-mechanical/drawings/dxf/09_control_box_lid.dxf
FRONT
TOP
LEFT
HP-09 09_control_box_lid 1:1 mm first-angle v0.1
