zyyyyy07/hpipac-heater/3-mechanical/drawings/dxf/06_humidifier_plate_AL6061.dxf

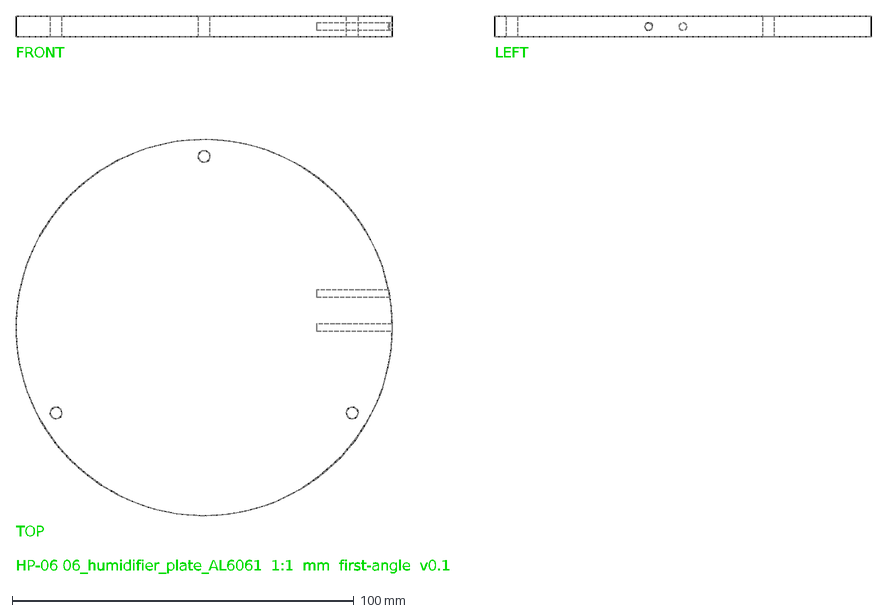
[picture p29: CAD file, 2026-11-13]
3-mechanical/drawings/dxf/06_humidifier_plate_AL6061.dxf
FRONT
TOP
LEFT
HP-06 06_humidifier_plate_AL6061 1:1 mm first-angle v0.1
