zyyyyy07/hpipac-heater/3-mechanical/drawings/dxf/05_syringe_jacket_half.dxf

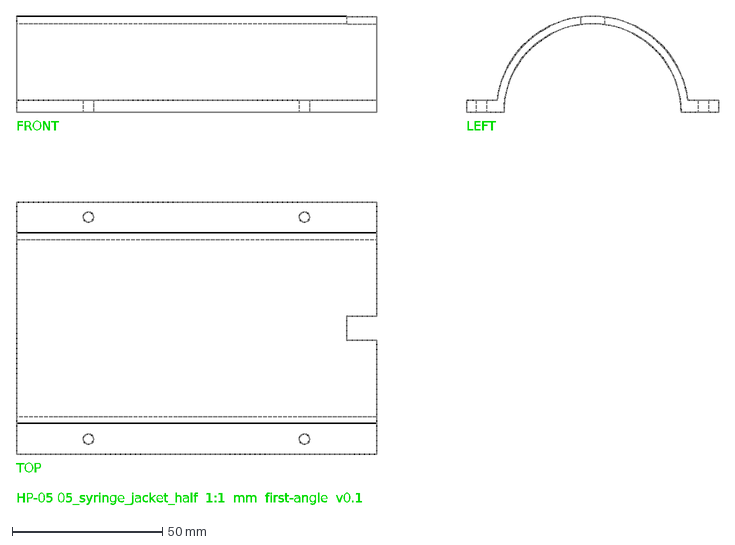
[picture p30: CAD file, 2026-11-13]
3-mechanical/drawings/dxf/05_syringe_jacket_half.dxf
FRONT
TOP
LEFT
HP-05 05_syringe_jacket_half 1:1 mm first-angle v0.1
