zyyyyy07/hpipac-heater/3-mechanical/drawings/dxf/06_loadcell_mount.dxf

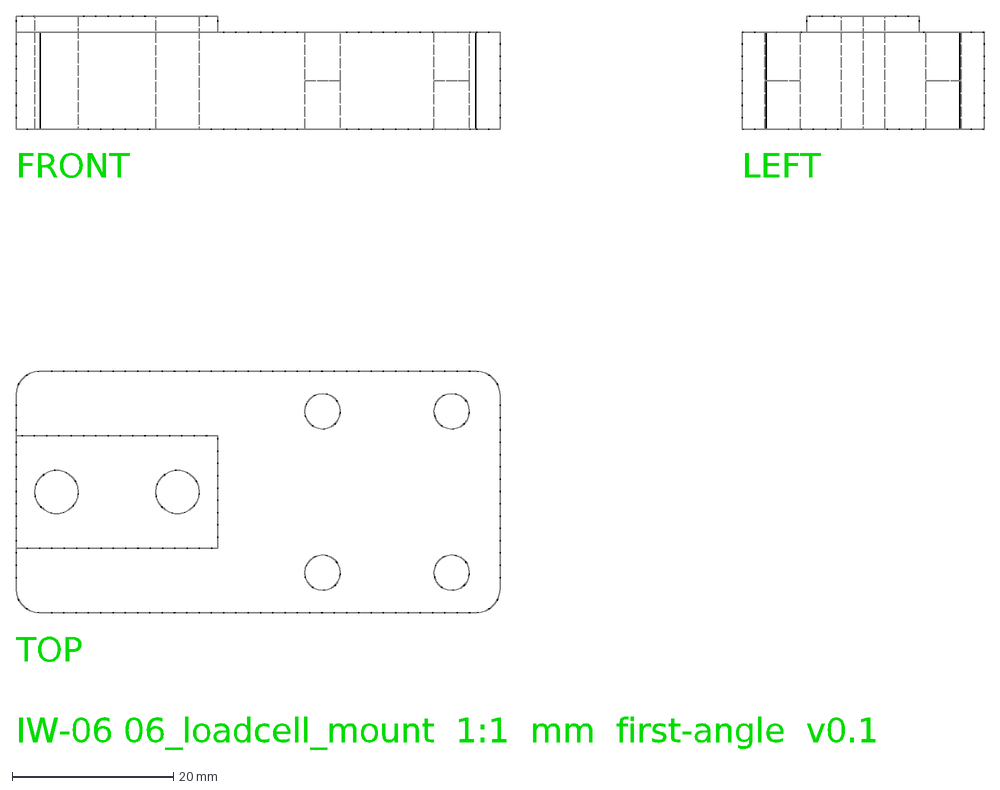
[picture p31: CAD file, 2026-11-12]
3-mechanical/drawings/dxf/06_loadcell_mount.dxf
FRONT
TOP
LEFT
IW-06 06_loadcell_mount 1:1 mm first-angle v0.1
