zyyyyy07/hpipac-heater/3-mechanical/drawings/dxf/01_plate_lower_AL6061.dxf

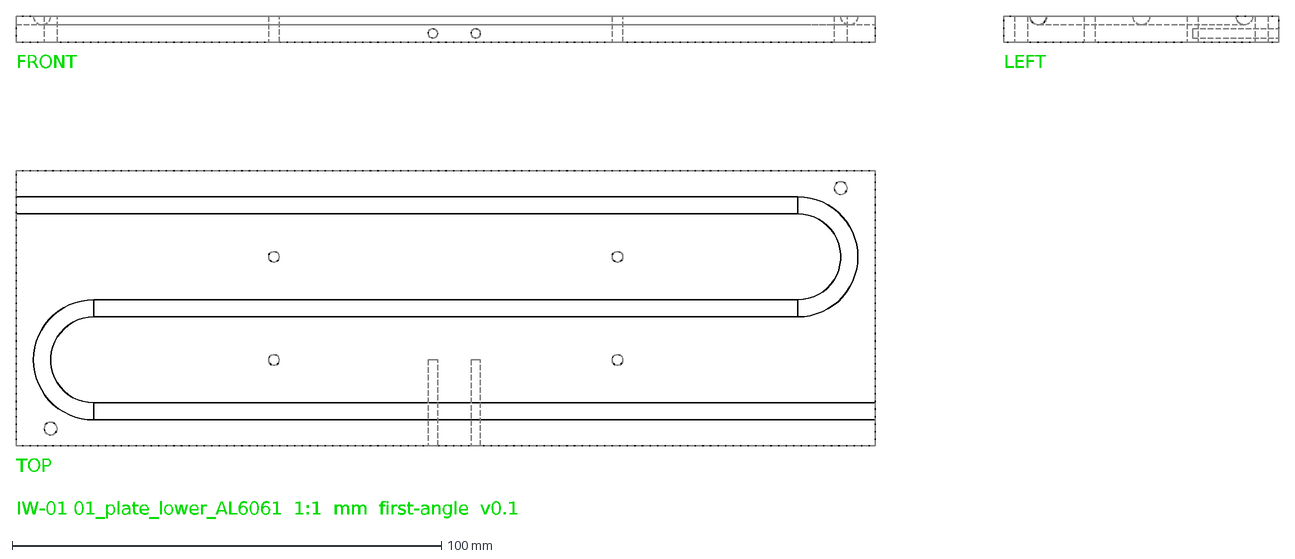
[picture p32: CAD file, 2026-11-12]
3-mechanical/drawings/dxf/01_plate_lower_AL6061.dxf
FRONT
TOP
LEFT
IW-01 01_plate_lower_AL6061 1:1 mm first-angle v0.1
