zyyyyy07/hpipac-heater/3-mechanical/drawings/dxf/02_plate_upper_AL6061.dxf

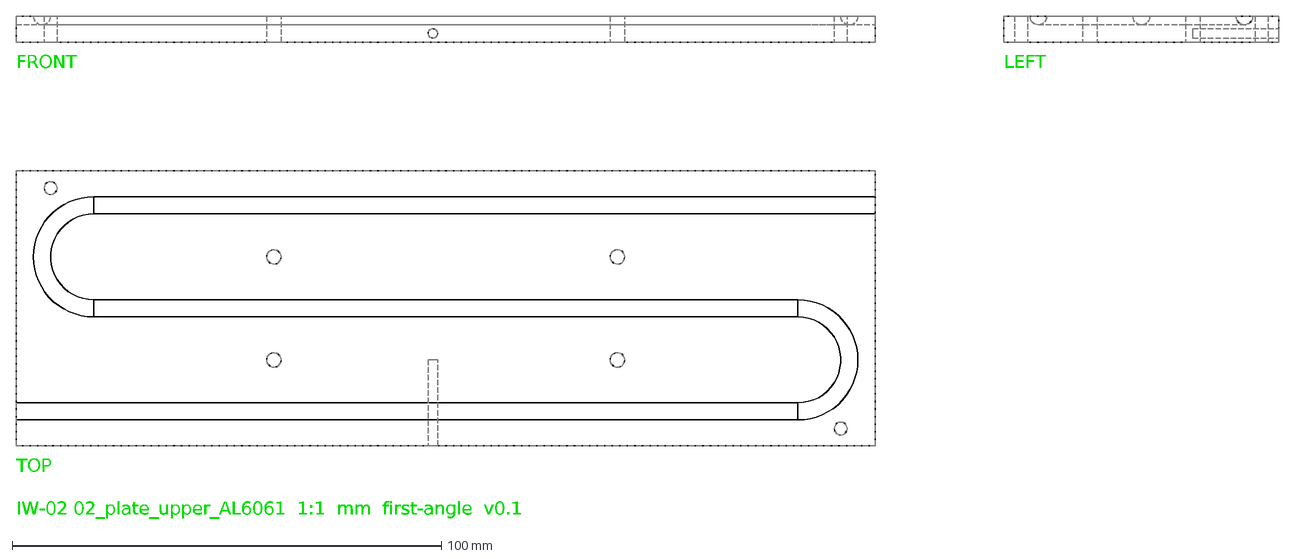
[picture p33: CAD file, 2026-11-12]
3-mechanical/drawings/dxf/02_plate_upper_AL6061.dxf
FRONT
TOP
LEFT
IW-02 02_plate_upper_AL6061 1:1 mm first-angle v0.1
