zyyyyy07/hpipac-heater/3-mechanical/drawings/dxf/04_heater_shell_upper.dxf

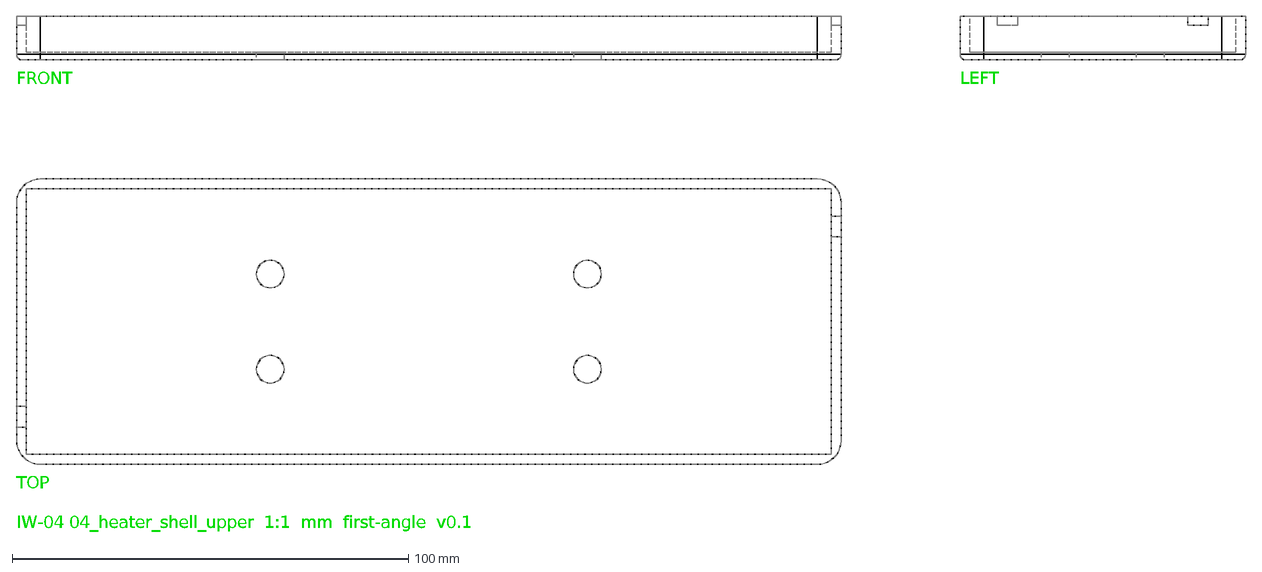
[picture p34: CAD file, 2026-11-12]
3-mechanical/drawings/dxf/04_heater_shell_upper.dxf
FRONT
TOP
LEFT
IW-04 04_heater_shell_upper 1:1 mm first-angle v0.1
