zyyyyy07/hpipac-heater/(list of files, cad)

Other CAD files:
3-mechanical/models/cnc/06_humidifier_plate_AL6061.step
3-mechanical/models/print/07_humidifier_base.step
3-mechanical/models/print/08_control_box_body.step
3-mechanical/models/print/09_control_box_lid.step
3-mechanical/models/print/04_syringe_jacket_half.stl
3-mechanical/models/print/06_humidifier_base.stl
3-mechanical/models/print/07_control_box_body.stl
3-mechanical/models/print/08_control_box_body.stl
3-mechanical/models/print/08_control_box_lid.stl
3-mechanical/models/print/09_control_box_lid.stl
