zyyyyy07/hpipac-heater/7-testing/README.md

[← 上一步:软件](../6-software/README.md) · [总览](../README.md) · [回到总览 →](../README.md)

# 第 7 步 · 分步测试

硬件装好后按 T1 到 T19 的顺序一步一步测,每一步通过再做下一步。**全程用水或生理盐水,在模型腹腔上做,不接病人,不用化疗药。** 串口命令在 `pio device monitor` 里输入,命令说明见[第 5 步](../5-firmware/README.md)。

模型腹腔:一个 10–15 L 的密闭透明塑料箱,顶面换成硅胶膜,开 3–4 个穿刺器孔,箱底放一层 37 ℃ 的恒温水浴模拟体温。

## 基础

| 步骤 | 内容 | 做法 | 通过标准 |
| --- | --- | --- | --- |
| T1 | 上电自检 | 不接任何加热片和泵。上电,输入 `status` | 三块模数转换都在线;各路温度接近室温;指示灯和蜂鸣器不乱响 |
| T2 | 温度校准 | 所有探头和独立温控器的探头捆在一起,放入 37、42、45 ℃ 水中,与精密温度计比对,把偏差填进 config.h | 校准后各路与标准温度计相差 ≤0.2 ℃ |
| T3 | 压力校准 | 腹腔压力传感器和水柱压力计并联,加 0、12、18 mmHg;雾化气压传感器和压力表并联,加 0、50、100 kPa | 腹腔压力误差 ≤1 mmHg;雾化气压误差 ≤5 kPa |

## 喷头(本方案的核心,先在敞开环境里测)

| 步骤 | 内容 | 做法 | 通过标准 |
| --- | --- | --- | --- |
| T4 | 喷头气密 | 堵住喷口,歧管充气到 100 kPa,泡在水里 | 各接口和插孔无气泡 |
| T5 | 气流和气压 | 只通气不通水。泵从 5 调到 15 L/min,记录每档的雾化气压 | 12 L/min 时气压在 30–120 kPa 之间;记录这条曲线,用来标定流量 |
| T6 | 能不能成雾 | 12 L/min 通气,注射泵推水 0.05、0.1、0.2 mL/s。对着黑背景和侧光看 | 0.1 mL/s 及以下是均匀的雾,没有滴水和粗水柱;雾不偏向一边。偏了就重新对中毛细管 |
| T7 | 雾滴大小 | 用激光粒度仪测;没有的话让雾落在涂了硅油的玻片上,显微镜下量 | 记录中位直径。没有预设通过线,目标是不比现有 PIPAC 喷头(几十微米)粗 |
| T8 | 喷雾分布 | 模型腹腔内壁和底面贴满滤纸,喷 50 mL 加了色素的水,喷头固定不动 | 拍照记录着色范围。看正对喷口处和四周的深浅差别 |
| T9 | 回气带走多少 | 模型腹腔按正常回路循环,过滤器先称重。喷 50 mL 盐水后再称过滤器 | 记录过滤器增重占喷入量的比例。这是决定方案能否成立的数,超过 20% 就要改成间歇喷雾 |

## 加热

| 步骤 | 内容 | 做法 | 通过标准 |
| --- | --- | --- | --- |
| T10 | 注射筒加热套 | 针筒装室温水,装上加热套,启动预热。针筒中心插热电偶 | 套温不超过 43.0 ℃;记录水到 41 ℃ 的时间 |
| T11 | 歧管加热和出口药液温度 | 四路预热到温后,12 L/min、0.1 mL/s 喷水,在喷口下方 5 mm 用细热电偶测雾的温度 | 歧管不超过 43.0 ℃;雾的温度 ≥39 ℃ 且 ≤43 ℃ |
| T12 | 加湿底座和输气管 | 加湿罐加水,12 L/min。测罐出口和喷头端的气温、湿度 | 喷头端气温到目标 ±1 ℃;相对湿度 ≥90%;管内无积水流进喷头 |
| T13 | 缺水 | 接 T12,把加湿罐的水倒空 | 报缺水并停止底座加热;底座不超过 88 ℃ |
| T14 | 保护 | 分别:用热风加热各路保护探头;把程序控制的开关短接让加热片常开(人不要离开);逐一拔探头;堵住喷口;运行中拔电源 | 程序过温立即关闭并锁定;独立温控器在 45 ℃ 断开,峰值 ≤48 ℃;拔探头报传感器故障;堵喷口 3 秒内报喷头堵塞并停泵;断电后全停,重新上电停在待机 |

## 回路和整机

| 步骤 | 内容 | 做法 | 通过标准 |
| --- | --- | --- | --- |
| T15 | 回路密闭性 | 回路接上模型腹腔,充气到 15 mmHg,关闭气源。停泵保持 30 分钟;再开泵 12 L/min 保持 30 分钟 | 压力下降 ≤1 mmHg;泵后的正压段每个接头用检漏液查无气泡 |
| T16 | 回路压力保护 | 循环中夹闭回气管,再夹闭输气管,再拔开一个接头 | 分别报压力低、喷头堵塞或压力高、压力低,并立即停泵 |
| T17 | 腹腔升温 | 模型腹腔底部水浴 37 ℃,循环 10 L/min,目标 42 ℃。箱内 4 个位置放热电偶 | 记录各点到 40、41、42 ℃ 的时间和稳态值。没有预设通过线,它回答“能升到多少度” |
| T18 | 全流程 | 按预热 → 就绪 → 喷雾(用水)→ 暴露 → 排气走一遍,全部在主机触摸屏上操作;暴露阶段人员到门外,确认透过门窗能看清指示灯、隔门能听到蜂鸣器 | 各阶段加热和泵的状态与[接口约定](../1-design/interface-spec.md)一致;喷雾阶段泵在转;暴露计时准确;记录文件完整;门外能看到灯、听到报警 |
| T19 | 外表面温度和固定 | 四路稳定 30 分钟后测所有手能碰到的表面;轻拉输气管和药液细管 | 歧管保温层外表面 ≤41 ℃;加湿底座外壁记录实测值,超过 48 ℃ 要加防护;拉管子时喷头不受力 |

> T14 里短接开关是故意让加热失控的试验。旁边不放易燃物。任一路超过 70 ℃ 而保护仍未动作时立即拔电源。

## 台架之后

T1–T19 全部通过只说明设备在模型上按设计工作。之后依次是:离体组织实验(看高速气流直吹会不会伤腹膜、药物渗透深度)、动物实验(需要伦理审批)、注册检验。见[设计方案第 9 节](../1-design/README.md)。

## 已知的风险点

- **回气会带走药。** 这是气助雾化固有的问题,T9 的结果决定方案要不要改。
- **加湿罐和输气管的耐压。** 它们在泵的出口侧,要承受几十 kPa,普通呼吸耗材不是按这个压力设计的。买不到耐压的就要改回路布局,这个问题还没有解决。
- **喷雾时间长。** 药液流速只有标准 PIPAC 的五分之一到十分之一。
- **喷口对中。** 环形气隙只有 0.2 mm,毛细管偏心雾就歪。
- **喷嘴堵塞。** 药液结晶或颗粒可能堵毛细管,用完要立即冲洗。
- **循环回路的接头是化疗药气溶胶的潜在泄漏点。** T15 只验证了空气下的密闭性。
- **过滤器受潮后阻力增大**,流量和雾化气压都会掉。
- 雾滴大小、能升到多少度、被带走多少药都只有估算,没有做过仿真。
- 循环流量按泵的占空比估算,没有流量传感器,用 T5 的曲线标定。

---

[← 上一步:软件](../6-software/README.md) · [总览](../README.md) · [回到总览 →](../README.md)
