zyyyyy07/hpipac-heater/3-mechanical/drawings/HP-drawings.pdf

主视图 | 左视图

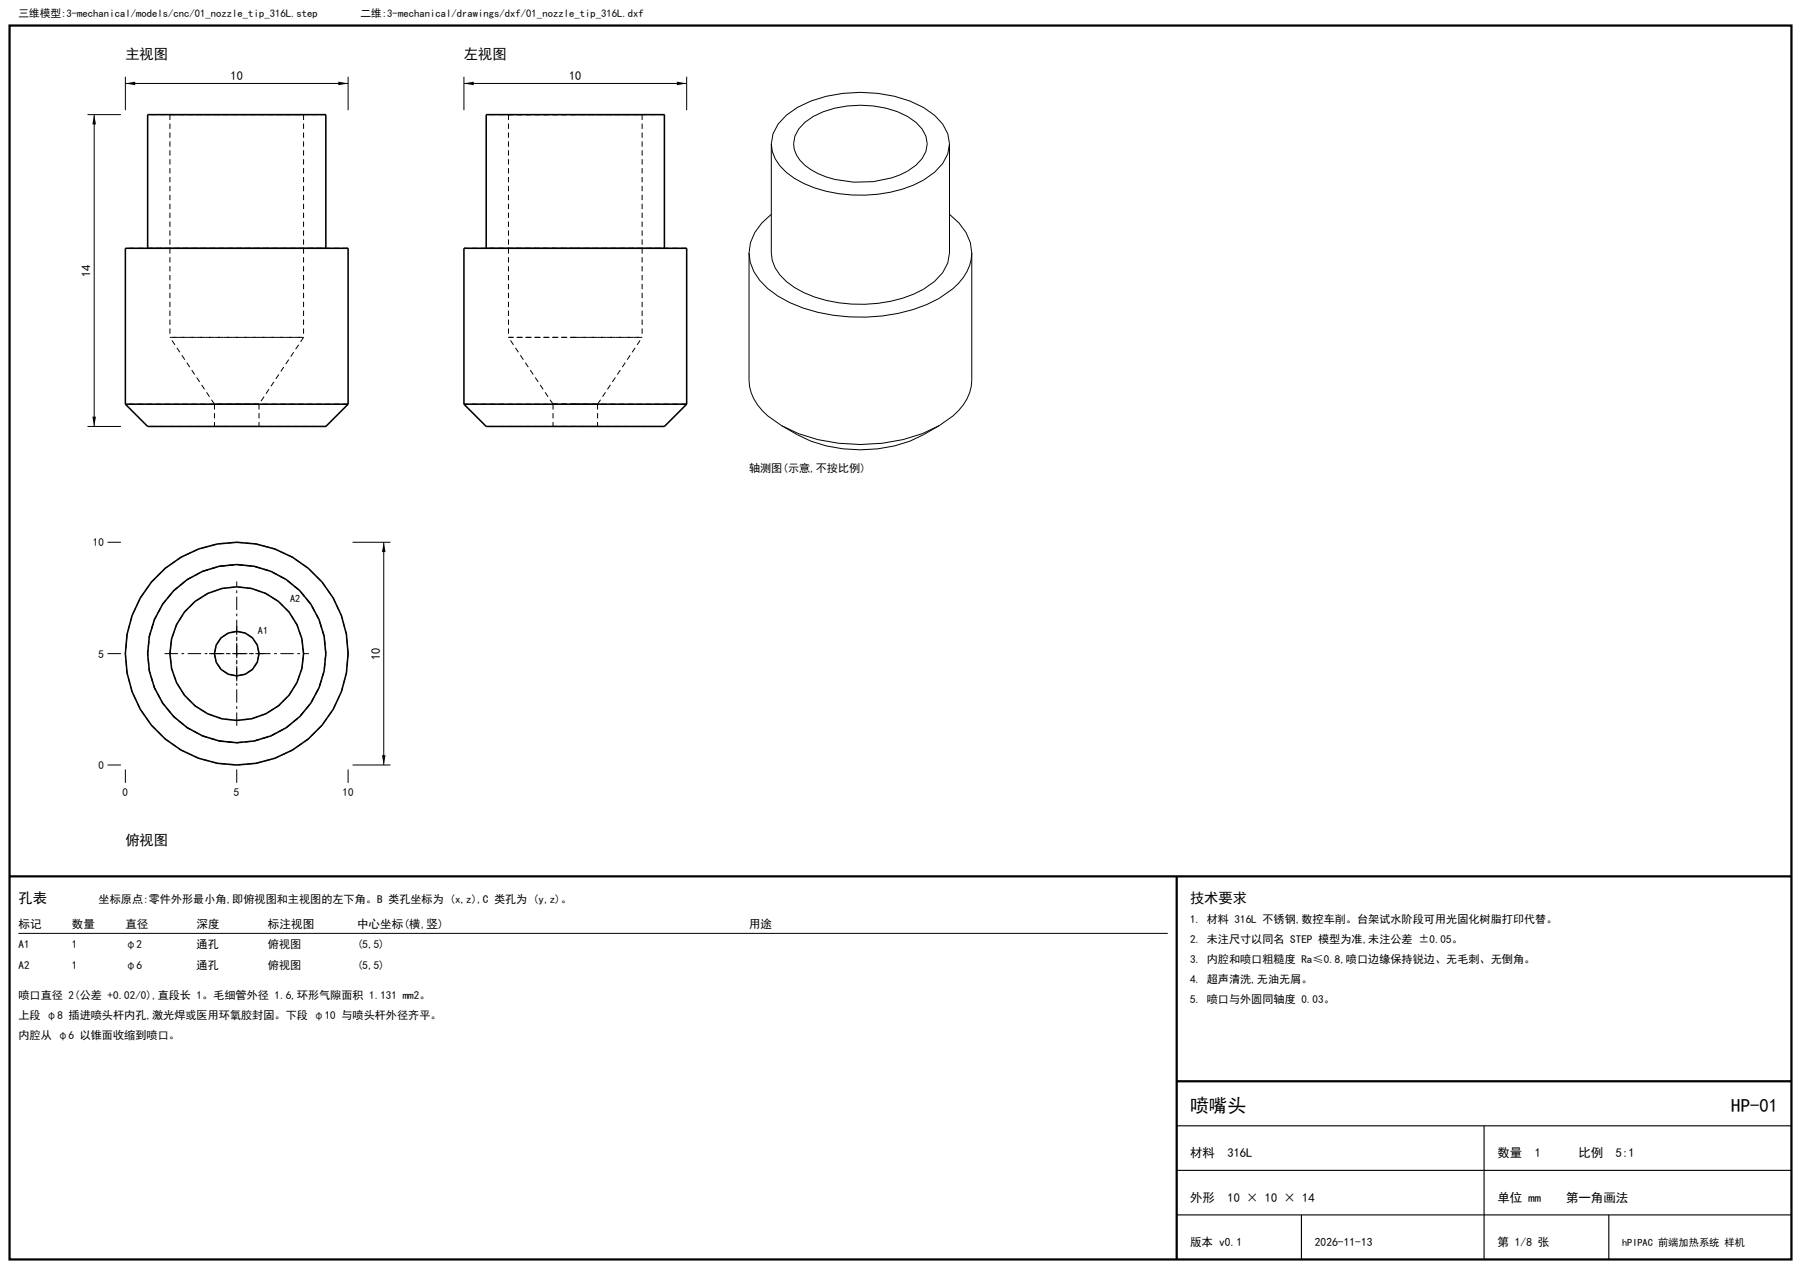
[picture p35: page 1]
俯视图; 坐标原点:零件外形最小角,即俯视图和主视图的左下角。B 类孔坐标为 (x,z),C 类孔为 (y,z)。; 标注视图; 中心坐标(横,竖); 技术要求; 喷嘴头; 第一角画法; hPIPAC 前端加热系统 样机; 三维模型:3-mechanical/models/cnc/01_nozzle_tip_316L.step; 二维:3-mechanical/drawings/dxf/01_nozzle_tip_316L.dxf

轴测图(示意,不按比例)

1. 材料 316L 不锈钢,数控车削。台架试水阶段可用光固化树脂打印代替。
2. 未注尺寸以同名 STEP 模型为准,未注公差 ±0.05。
3. 内腔和喷口粗糙度 Ra≤0.8,喷口边缘保持锐边、无毛刺、无倒角。
4. 超声清洗,无油无屑。
5. 喷口与外圆同轴度 0.03。

喷口直径 2(公差 +0.02/0),直段长 1。毛细管外径 1.6,环形气隙面积 1.131 mm2。
上段 φ8 插进喷头杆内孔,激光焊或医用环氧胶封固。下段 φ10 与喷头杆外径齐平。
内腔从 φ6 以锥面收缩到喷口。

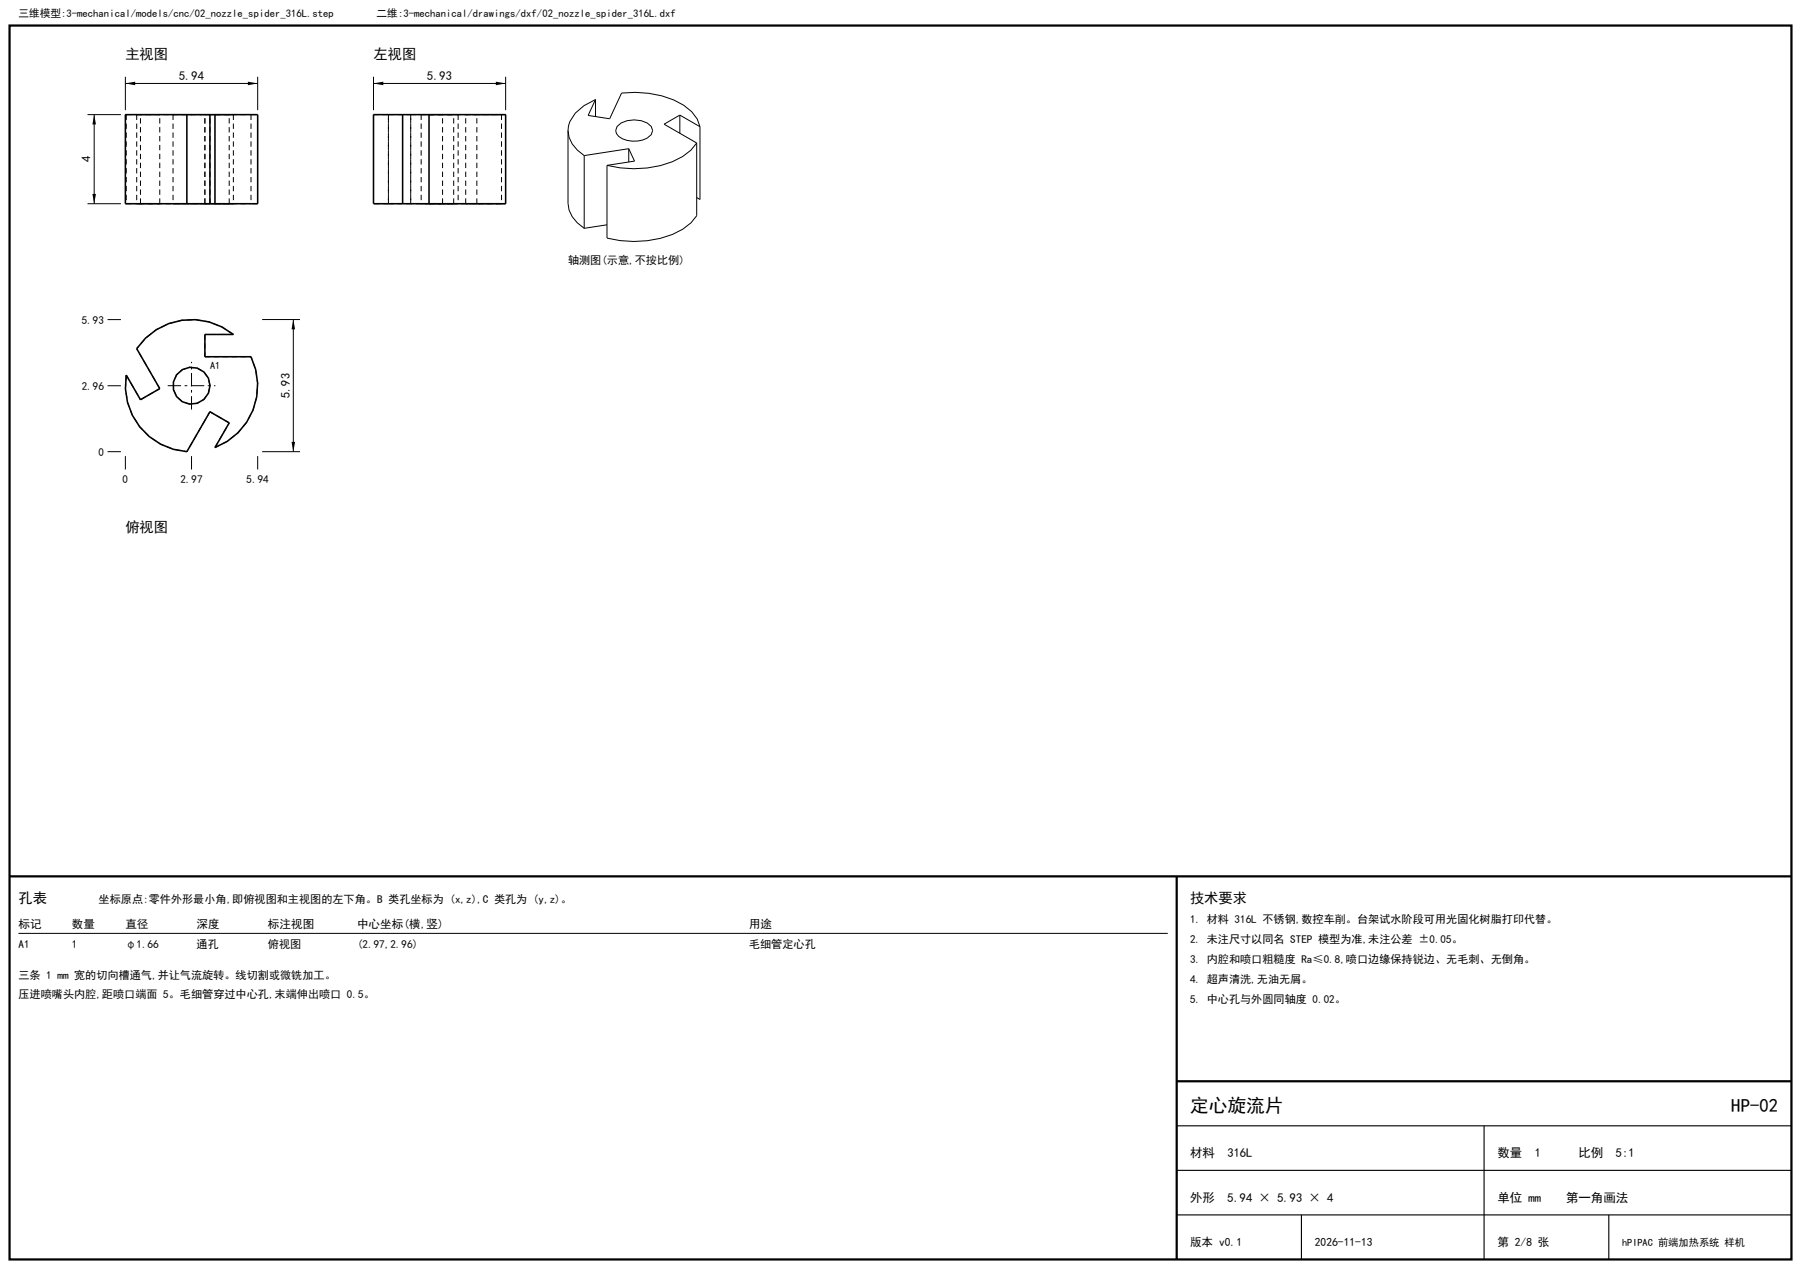
[picture p36: page 2]
俯视图; 坐标原点:零件外形最小角,即俯视图和主视图的左下角。B 类孔坐标为 (x,z),C 类孔为 (y,z)。; 标注视图; 中心坐标(横,竖); 毛细管定心孔; 技术要求; 定心旋流片; 第一角画法; hPIPAC 前端加热系统 样机; 三维模型:3-mechanical/models/cnc/02_nozzle_spider_316L.step; 二维:3-mechanical/drawings/dxf/02_nozzle_spider_316L.dxf

轴测图(示意,不按比例)

1. 材料 316L 不锈钢,数控车削。台架试水阶段可用光固化树脂打印代替。
2. 未注尺寸以同名 STEP 模型为准,未注公差 ±0.05。
3. 内腔和喷口粗糙度 Ra≤0.8,喷口边缘保持锐边、无毛刺、无倒角。
4. 超声清洗,无油无屑。
5. 中心孔与外圆同轴度 0.02。

三条 1 mm 宽的切向槽通气,并让气流旋转。线切割或微铣加工。
压进喷嘴头内腔,距喷口端面 5。毛细管穿过中心孔,末端伸出喷口 0.5。

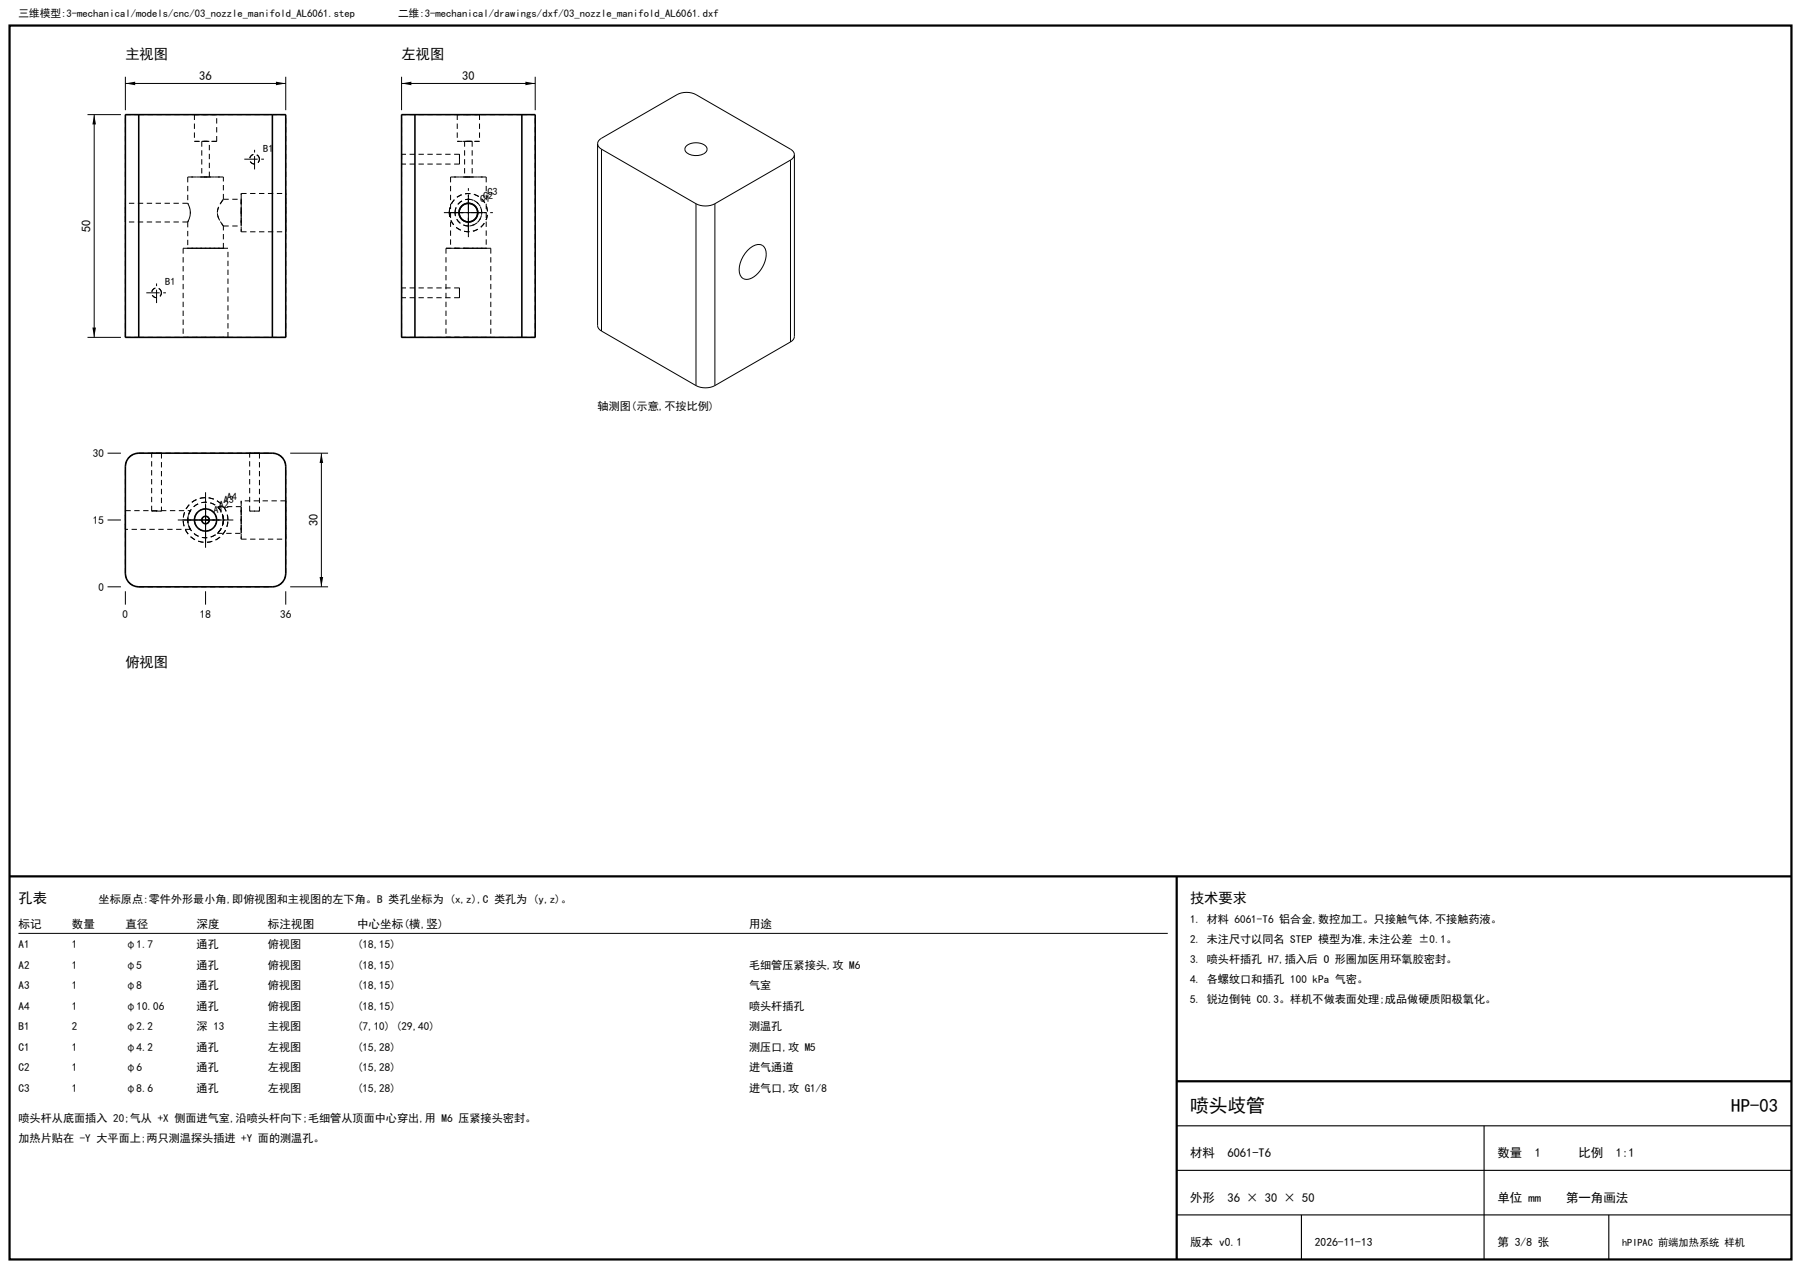
[picture p37: page 3]
俯视图; 坐标原点:零件外形最小角,即俯视图和主视图的左下角。B 类孔坐标为 (x,z),C 类孔为 (y,z)。; 标注视图; 中心坐标(横,竖); 毛细管压紧接头,攻 M6; 喷头杆插孔; 主视图; 测温孔; 左视图; 测压口,攻 M5; 进气通道; 进气口,攻 G1/8; 技术要求; 喷头歧管; 第一角画法; hPIPAC 前端加热系统 样机; 三维模型:3-mechanical/models/cnc/03_nozzle_manifold_AL6061.step; 二维:3-mechanical/drawings/dxf/03_nozzle_manifold_AL6061.dxf

轴测图(示意,不按比例)

1. 材料 6061-T6 铝合金,数控加工。只接触气体,不接触药液。
2. 未注尺寸以同名 STEP 模型为准,未注公差 ±0.1。
3. 喷头杆插孔 H7,插入后 O 形圈加医用环氧胶密封。
4. 各螺纹口和插孔 100 kPa 气密。
5. 锐边倒钝 C0.3。样机不做表面处理;成品做硬质阳极氧化。

喷头杆从底面插入 20;气从 +X 侧面进气室,沿喷头杆向下;毛细管从顶面中心穿出,用 M6 压紧接头密封。
加热片贴在 -Y 大平面上;两只测温探头插进 +Y 面的测温孔。

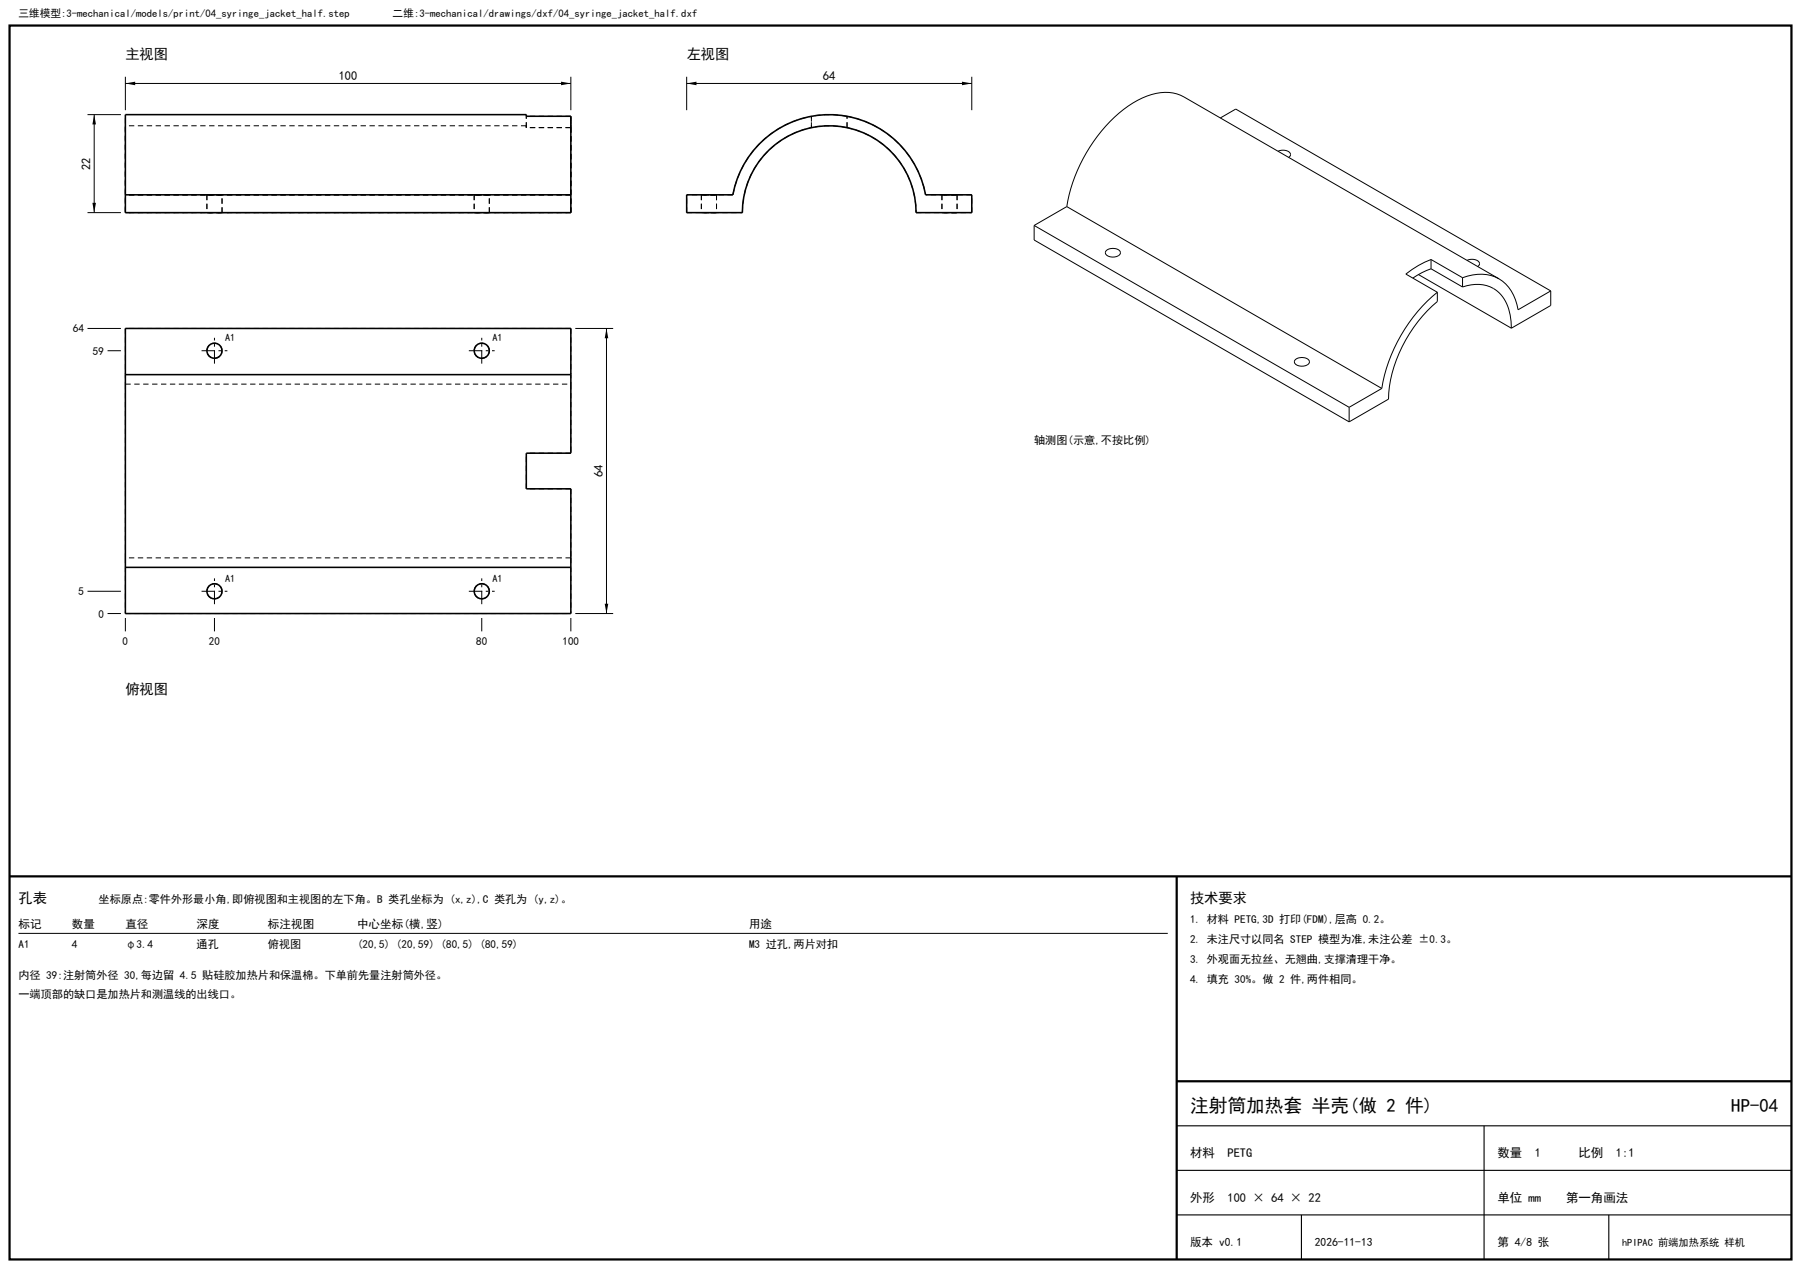
[picture p38: page 4]
俯视图; 坐标原点:零件外形最小角,即俯视图和主视图的左下角。B 类孔坐标为 (x,z),C 类孔为 (y,z)。; 标注视图; 中心坐标(横,竖); M3 过孔,两片对扣; 技术要求; 注射筒加热套 半壳(做 2 件); 材料 PETG; 第一角画法; hPIPAC 前端加热系统 样机; 三维模型:3-mechanical/models/print/04_syringe_jacket_half.step; 二维:3-mechanical/drawings/dxf/04_syringe_jacket_half.dxf

轴测图(示意,不按比例)

1. 材料 PETG,3D 打印(FDM),层高 0.2。
2. 未注尺寸以同名 STEP 模型为准,未注公差 ±0.3。
3. 外观面无拉丝、无翘曲,支撑清理干净。
4. 填充 30%。做 2 件,两件相同。

内径 39:注射筒外径 30,每边留 4.5 贴硅胶加热片和保温棉。下单前先量注射筒外径。
一端顶部的缺口是加热片和测温线的出线口。

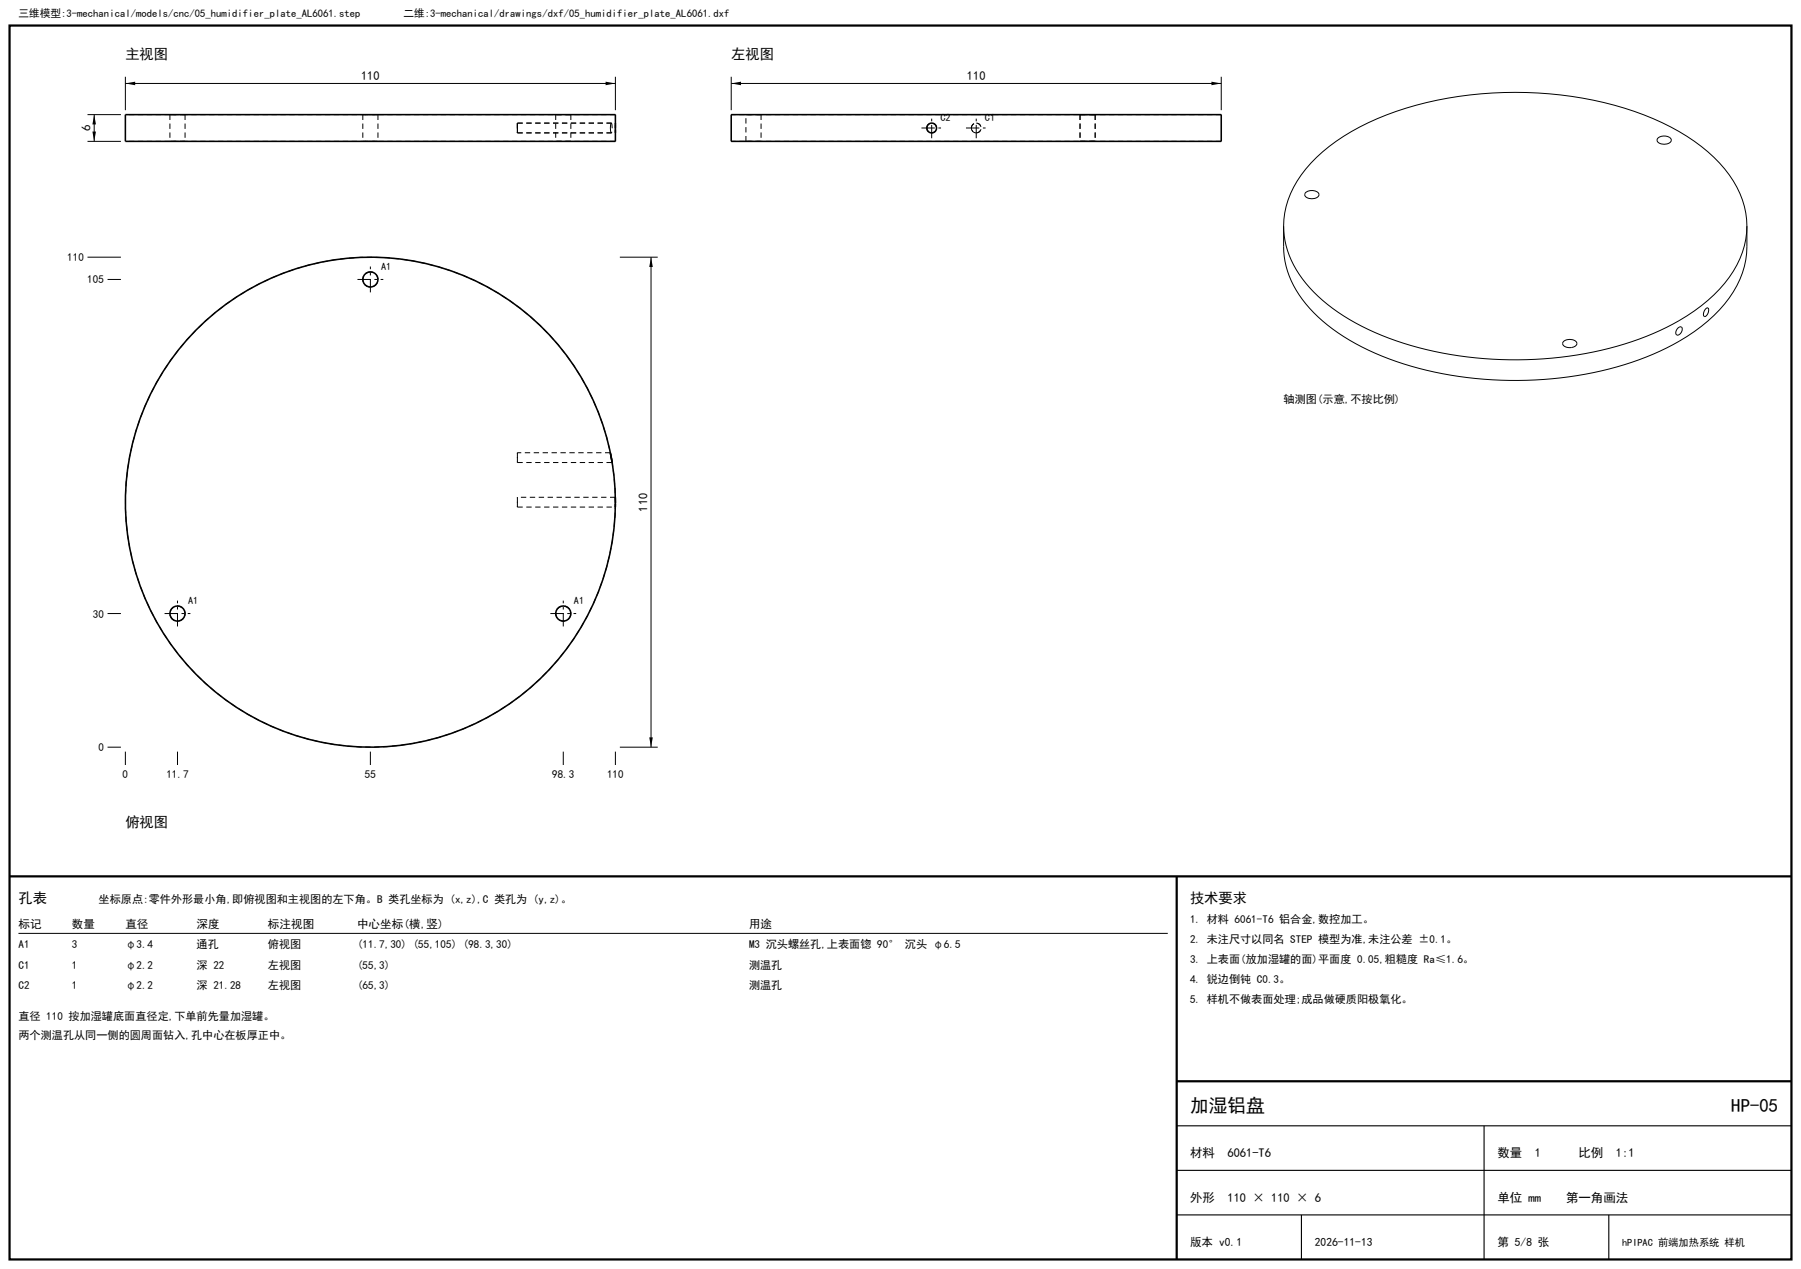
[picture p39: page 5]
俯视图; 坐标原点:零件外形最小角,即俯视图和主视图的左下角。B 类孔坐标为 (x,z),C 类孔为 (y,z)。; 标注视图; 中心坐标(横,竖); M3 沉头螺丝孔,上表面锪 90° 沉头 φ6.5; 左视图; 测温孔; 技术要求; 加湿铝盘; 第一角画法; hPIPAC 前端加热系统 样机; 三维模型:3-mechanical/models/cnc/05_humidifier_plate_AL6061.step; 二维:3-mechanical/drawings/dxf/05_humidifier_plate_AL6061.dxf

轴测图(示意,不按比例)

1. 材料 6061-T6 铝合金,数控加工。
2. 未注尺寸以同名 STEP 模型为准,未注公差 ±0.1。
3. 上表面(放加湿罐的面)平面度 0.05,粗糙度 Ra≤1.6。
4. 锐边倒钝 C0.3。
5. 样机不做表面处理;成品做硬质阳极氧化。

直径 110 按加湿罐底面直径定,下单前先量加湿罐。
两个测温孔从同一侧的圆周面钻入,孔中心在板厚正中。

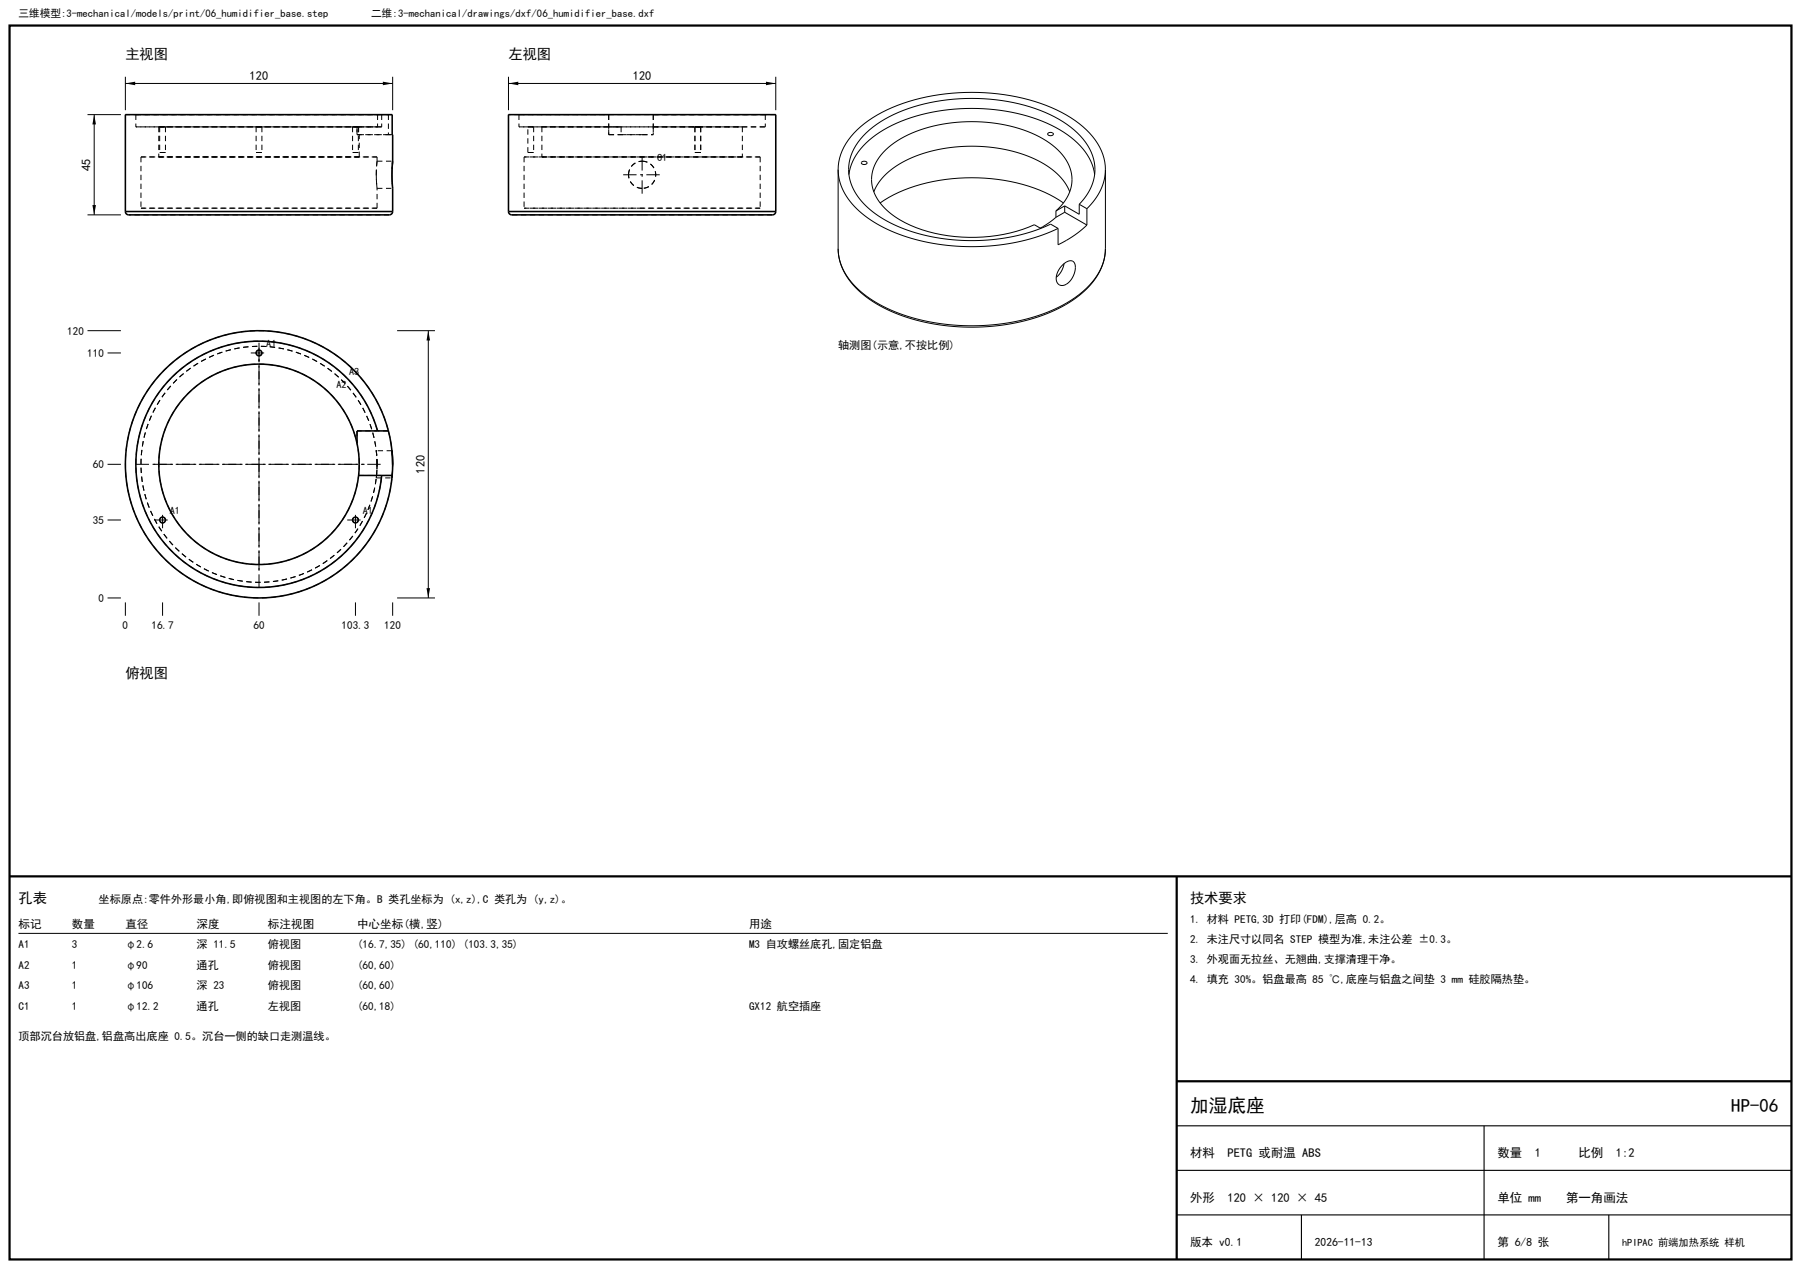
[picture p40: page 6]
俯视图; 坐标原点:零件外形最小角,即俯视图和主视图的左下角。B 类孔坐标为 (x,z),C 类孔为 (y,z)。; 标注视图; 中心坐标(横,竖); M3 自攻螺丝底孔,固定铝盘; 左视图; GX12 航空插座; 技术要求; 加湿底座; 材料 PETG 或耐温 ABS; 第一角画法; hPIPAC 前端加热系统 样机; 三维模型:3-mechanical/models/print/06_humidifier_base.step; 二维:3-mechanical/drawings/dxf/06_humidifier_base.dxf

轴测图(示意,不按比例)

1. 材料 PETG,3D 打印(FDM),层高 0.2。
2. 未注尺寸以同名 STEP 模型为准,未注公差 ±0.3。
3. 外观面无拉丝、无翘曲,支撑清理干净。
4. 填充 30%。铝盘最高 85 ℃,底座与铝盘之间垫 3 mm 硅胶隔热垫。

顶部沉台放铝盘,铝盘高出底座 0.5。沉台一侧的缺口走测温线。

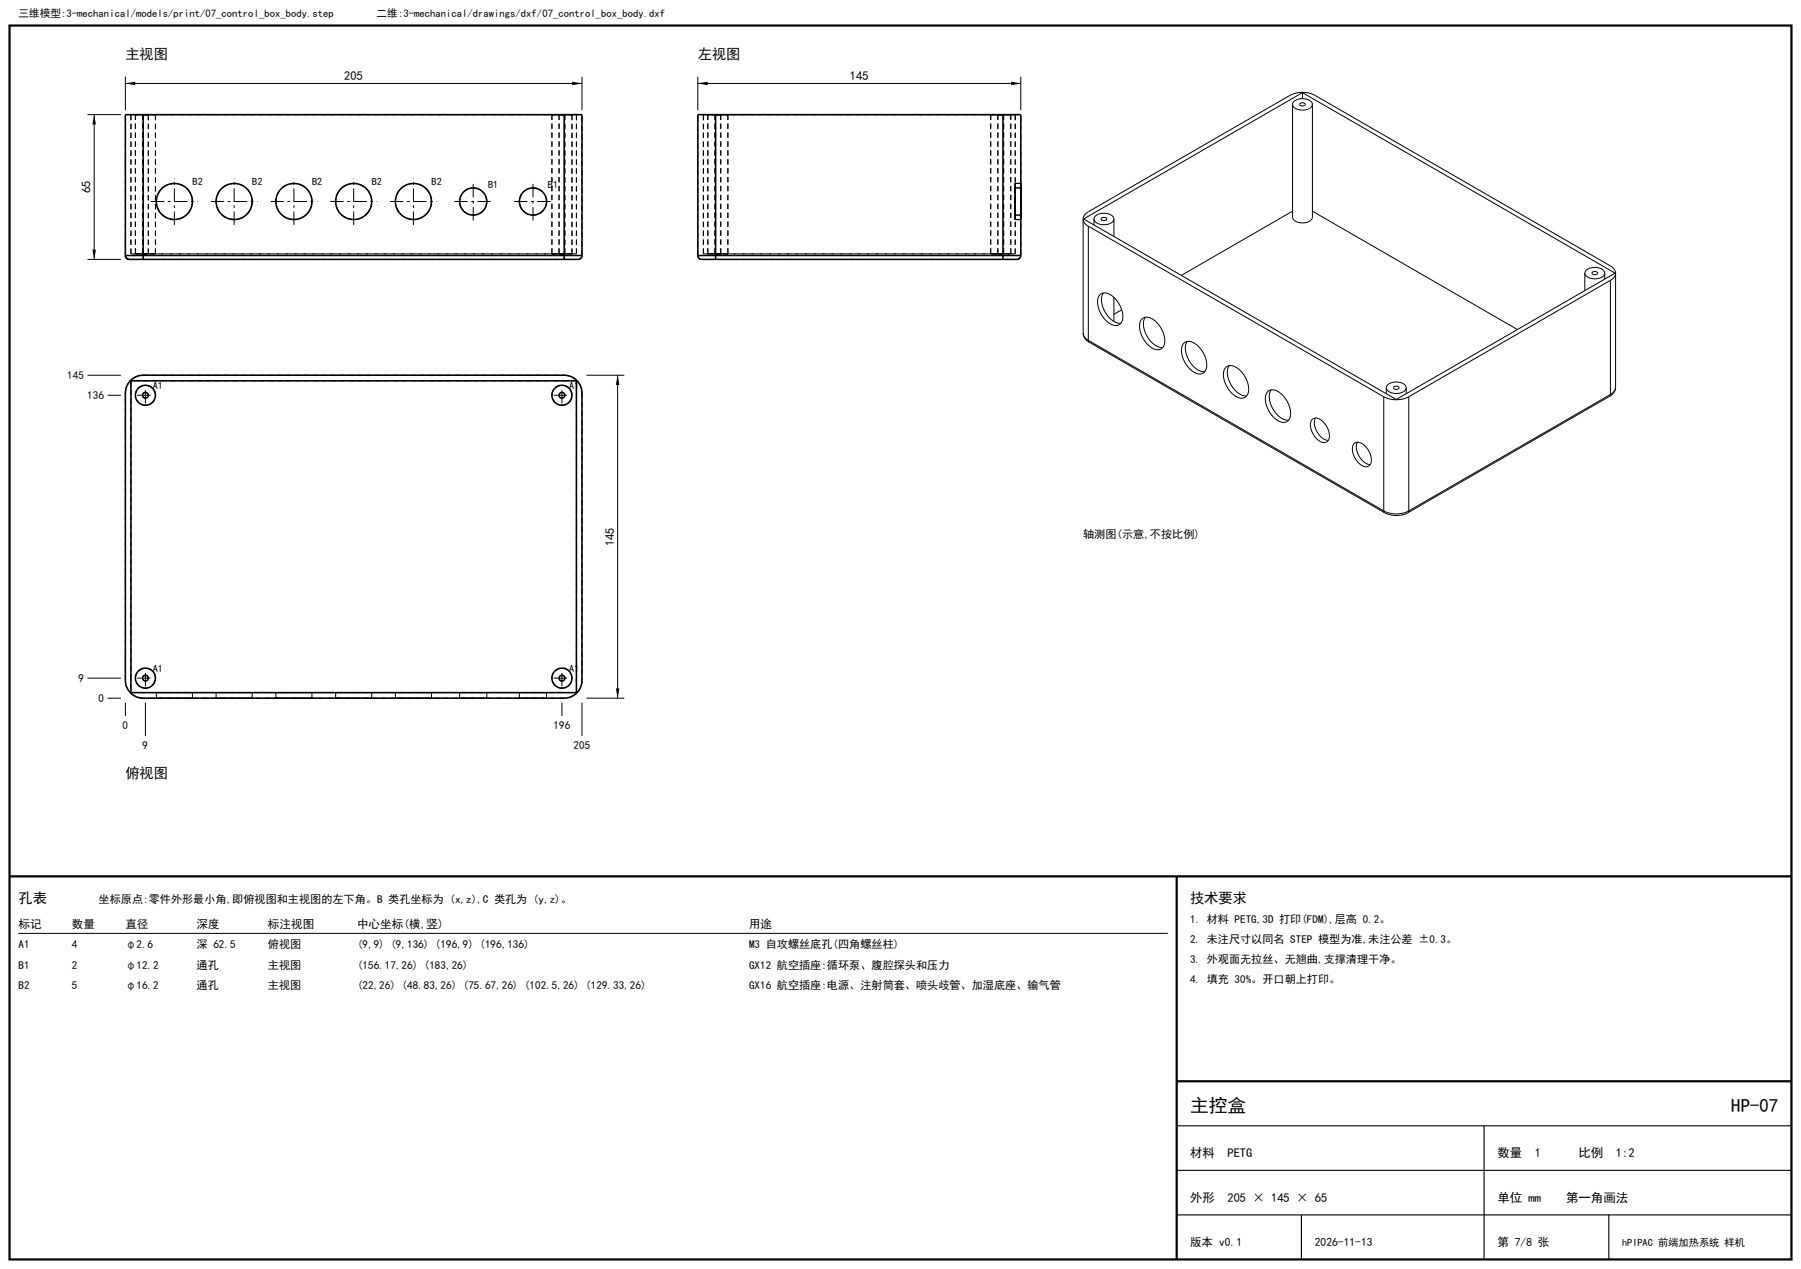
[picture p41: page 7]
俯视图; 坐标原点:零件外形最小角,即俯视图和主视图的左下角。B 类孔坐标为 (x,z),C 类孔为 (y,z)。; 标注视图; 中心坐标(横,竖); M3 自攻螺丝底孔(四角螺丝柱); 主视图; GX12 航空插座:循环泵、腹腔探头和压力; GX16 航空插座:电源、注射筒套、喷头歧管、加湿底座、输气管; 技术要求; 主控盒; 材料 PETG; 第一角画法; hPIPAC 前端加热系统 样机; 三维模型:3-mechanical/models/print/07_control_box_body.step; 二维:3-mechanical/drawings/dxf/07_control_box_body.dxf

轴测图(示意,不按比例)

1. 材料 PETG,3D 打印(FDM),层高 0.2。
2. 未注尺寸以同名 STEP 模型为准,未注公差 ±0.3。
3. 外观面无拉丝、无翘曲,支撑清理干净。
4. 填充 30%。开口朝上打印。

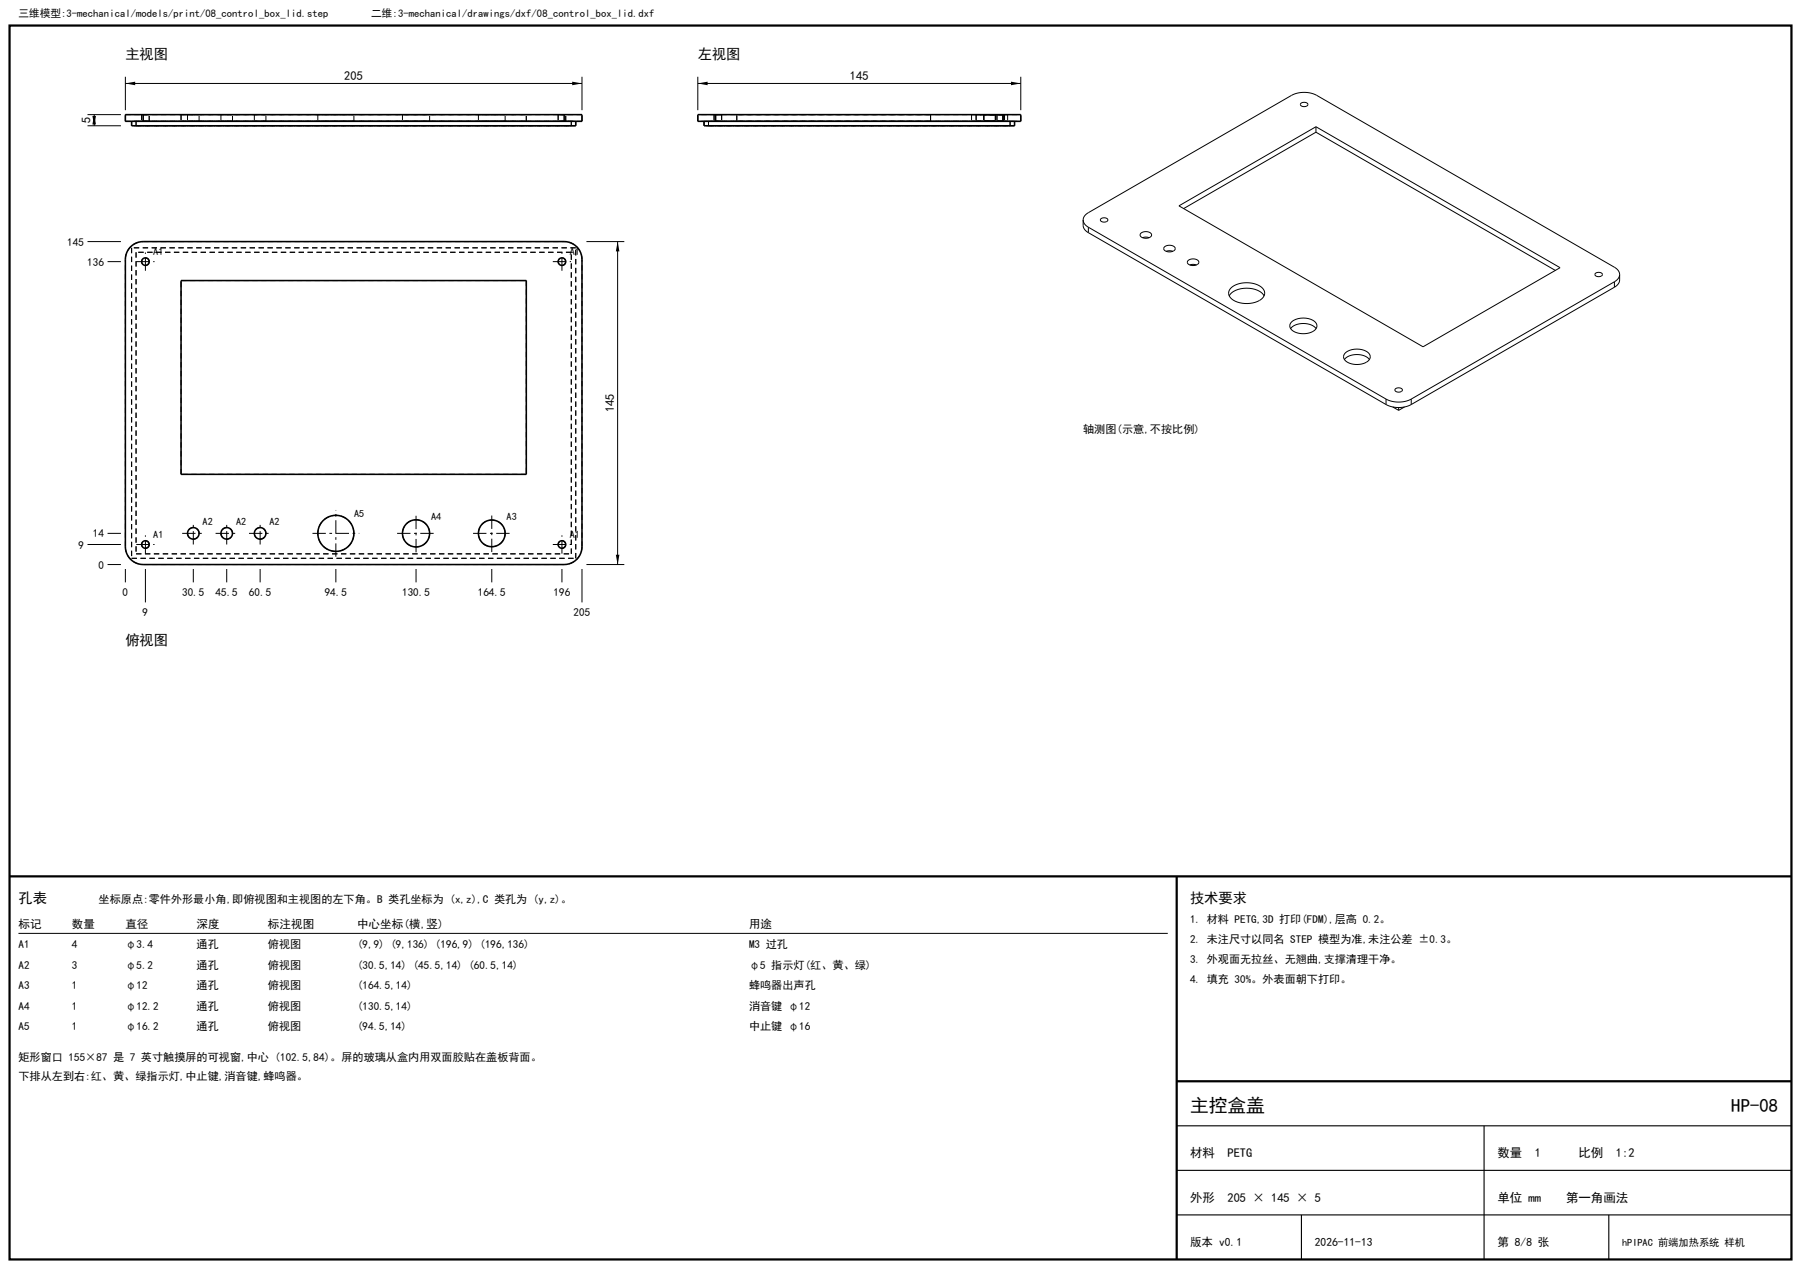
[picture p42: page 8]
俯视图; 坐标原点:零件外形最小角,即俯视图和主视图的左下角。B 类孔坐标为 (x,z),C 类孔为 (y,z)。; 标注视图; 中心坐标(横,竖); φ5 指示灯(红、黄、绿); 蜂鸣器出声孔; 消音键 φ12; 中止键 φ16; 技术要求; 主控盒盖; 材料 PETG; 第一角画法; hPIPAC 前端加热系统 样机; 三维模型:3-mechanical/models/print/08_control_box_lid.step; 二维:3-mechanical/drawings/dxf/08_control_box_lid.dxf

轴测图(示意,不按比例)

1. 材料 PETG,3D 打印(FDM),层高 0.2。
2. 未注尺寸以同名 STEP 模型为准,未注公差 ±0.3。
3. 外观面无拉丝、无翘曲,支撑清理干净。
4. 填充 30%。外表面朝下打印。

矩形窗口 155×87 是 7 英寸触摸屏的可视窗,中心 (102.5,84)。屏的玻璃从盒内用双面胶贴在盖板背面。
下排从左到右:红、黄、绿指示灯,中止键,消音键,蜂鸣器。
