zyyyyy07/hpipac-heater/(commit log)

2026-11-12 Infusion warmer prototype v0.1: design docs, server, firmware, CAD models and 3D viewer
    [01_plate_lower_AL6061.step, 01_plate_lower_AL6061.stl, 02_plate_upper_AL6061.step, 02_plate_upper_AL6061.stl, 03_heater_shell_lower.step, 03_heater_shell_lower.stl, 04_heater_shell_upper.step, 04_heater_shell_upper.stl]
2026-11-12 Add manufacturing drawing pack: A3 PDF sheets and DXF for all 8 parts
    Replaces the two plate SVG drawings with a generated pack (three views,
    overall dimensions, hole tables, tolerances, title block).
    [01_plate_lower_AL6061.dxf, 01_plate_lower_AL6061.step, 02_plate_upper_AL6061.dxf, 02_plate_upper_AL6061.step, 03_heater_shell_lower.dxf, 03_heater_shell_lower.step, 04_heater_shell_upper.dxf, 04_heater_shell_upper.step]
2026-11-12 Add host panel simulation page (OLED, LEDs, buttons)
2026-11-12 Replace OLED with 7-inch touchscreen; convert docs to Markdown
    - Control box resized to 205x145x65 with a 155x87 screen window; lid layout,
    drawings, DXF, STEP/STL regenerated
    - Firmware: OLED now optional (HAS_OLED 0 by default)
    - Panel simulation embeds the real bedside page; add Raspberry Pi kiosk script
    - docs/*.html converted to Markdown so they render on GitHub
    [01_plate_lower_AL6061.dxf, 01_plate_lower_AL6061.step, 02_plate_upper_AL6061.dxf, 02_plate_upper_AL6061.step, 03_heater_shell_lower.dxf, 03_heater_shell_lower.step, 04_heater_shell_upper.dxf, 04_heater_shell_upper.step]
2026-11-12 Reorganize into numbered step folders; bedside mounting for heater module
    - 1-design … 7-testing, each with a README and prev/next links; root README
    is a step-by-step roadmap
    - Models split into models/cnc and models/print
    - Lower heater shell gains two strap lugs; assembly view shows the module
    resting at the bedside instead of hanging on the tubing; add test T16
    [01_plate_lower_AL6061.dxf, 01_plate_lower_AL6061.step, 01_plate_lower_AL6061.stl, 02_plate_upper_AL6061.dxf, 02_plate_upper_AL6061.step, 02_plate_upper_AL6061.stl, 03_heater_shell_lower.dxf, 03_heater_shell_lower.step]
2026-11-13 Pivot to hPIPAC front-end heating system; remove all infusion content
    - New design: drug-path warming (syringe jacket + high-pressure line warmer,
    <=43 C) and heated humidified CO2 recirculation, target 41-43 C
    - Interface spec shared by firmware, server and console
    - Firmware rewritten: 4 heater channels + pump, phases, alarms (223 host checks)
    - Server rewritten: remote operating console, local touchscreen page, panel
    simulation, simulator, case logging (98 end-to-end checks)
    - CAD: syringe jacket, humidifier plate and base, line warmer, control box;
    9 drawing sheets; operating-room layout view
    - Purchase list, wiring, 18-step bench test plan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
    [01_line_plate_lower_AL6061.dxf, 01_line_plate_lower_AL6061.step, 02_line_plate_upper_AL6061.dxf, 02_line_plate_upper_AL6061.step, 03_heater_shell_lower.dxf, 03_heater_shell_lower.stl, 03_line_shell_lower.dxf, 03_line_shell_lower.step]
2026-11-13 Gas-assisted heated nebulizer nozzle replaces the line warmer
    The warm humidified CO2 from the recirculation loop is now the atomizing
    gas: it leaves through the nozzle, shears the drug stream from a central
    capillary into aerosol, carries heat into the cavity and stirs the gas.
    No high-pressure injector is needed any more; an ordinary syringe pump
    pushes the drug at low pressure.
    - CAD: nozzle tip, centring swirl disc, manifold (channel NOZ, max 43 C);
    high-pressure line warmer removed; 8 drawing sheets
    - Firmware: NOZ channel, nozP sensor, NOZ_BLOCK / NOZ_LOW, pump runs in
    NEBULIZE at nebFlow (256 host checks)
    - Software: console and touchscreen show atomizing pressure and a
    promine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
    [01_line_plate_lower_AL6061.dxf, 01_line_plate_lower_AL6061.step, 01_nozzle_tip_316L.dxf, 01_nozzle_tip_316L.step, 02_line_plate_upper_AL6061.dxf, 02_line_plate_upper_AL6061.step, 02_nozzle_spider_316L.dxf, 02_nozzle_spider_316L.step]
2026-11-13 Add one-click demo page and visual README for doctors
    - demo/: self-contained page with animated principle diagrams, a
    rotatable 3D viewer of the nozzle and operating-room layout, and an
    interactive surgery simulation (phases, alarms, stop-syringe-pump
    warning); published as a claude.ai artifact
    - README opens with the demo link, the system and nozzle diagrams as
    images, and links to assembly STL files GitHub shows in 3D
    - 3-mechanical/tools/export_web.py generates the web meshes and STLs
    [hum_assembly.stl, nozzle_assembly.stl, room_assembly.stl, syr_assembly.stl]
2026-11-13 Demo: replace remote console with the device front panel
    Touchscreen UI at 800x480 scale with overview and chart tabs, red/yellow/
    green LEDs, physical abort and mute keys, buzzer, stop-syringe-pump banner.
2026-11-13 Remove remote operation; the device is operated only on its own panel
    - 6-software: remote console deleted; the 7-inch touchscreen page is the
    only operating interface (run/curve/settings tabs, abort confirm,
    alarm ack, mute, offline states); recording starts and stops by itself;
    the Raspberry Pi in the box runs the server and its own hotspot
    (setup script, never run on a Pi) - 118 end-to-end checks
    - Firmware points at the in-box server http://10.42.0.1:8080
    - Spec section 7, design doc, wiring, test plan and README updated; the
    design doc states what staff outside the room can and cannot see
2026-11-13 Keep shell scripts LF so they run on the Raspberry Pi
2026-11-13 Simplify the touchscreen for use under pressure
    Main screen answers three questions only: which step, is everything OK,
    what to press next. Big cavity temperature with one status tag, four
    tick/cross checks, one primary button, abort fixed top-right; alarms
    replace the next-step area with a card (what happened, what the device
    did, numbered steps, acknowledge/mute). Everything else moved to Details.
    Rules documented in 1-design/touchscreen-ui.md.
2026-11-13 Touchscreen software follows the at-a-glance layout
    local.html rebuilt per 1-design/touchscreen-ui.md: step, cavity
    temperature with status tag, four checks, one next-step button, alarm
    card with numbered steps, everything else under Details (119 checks).
    Demo confirm buttons ordered the same as the device.
2026-11-14 Demo screen in patient-monitor style
    Big numbers and two-character labels, no sentences on the main screen;
    alarms take over the top bar (red flashing for high priority) with the
    alarm name and first action; explanations moved to Details. Rules and
    sources (IEC 60601-1-8, IEC 62366-1, monitor and HIPEC pump conventions)
    in 1-design/touchscreen-ui.md.
2026-11-14 Device touchscreen in patient-monitor style, matching the demo
